Croip3/MK4-Prototype/GehaeuseAiPrototype/vorschau/03_draufsicht.png

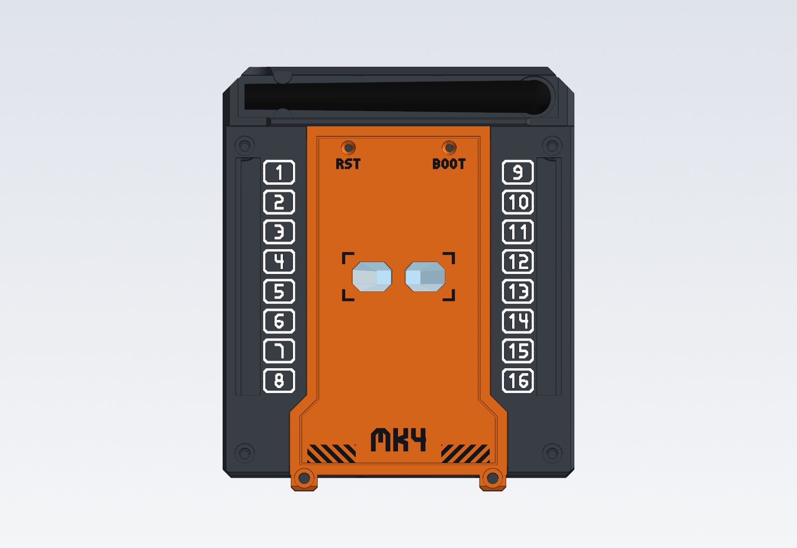
GehaeuseAiPrototype/vorschau/03_draufsicht.png
