Croip3/MK4-Prototype/GehaeuseAiPrototype/vorschau/05_unterseite.png

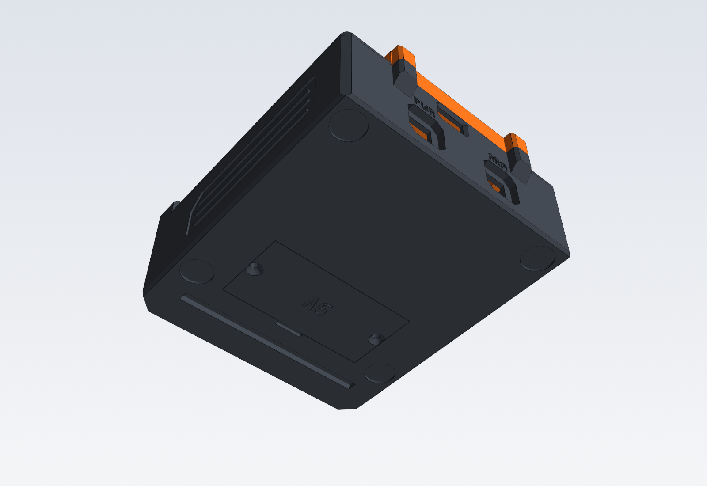
GehaeuseAiPrototype/vorschau/05_unterseite.png
