Croip3/MK4-Prototype/GehaeuseAiPrototype/vorschau/07_leuchtend.png

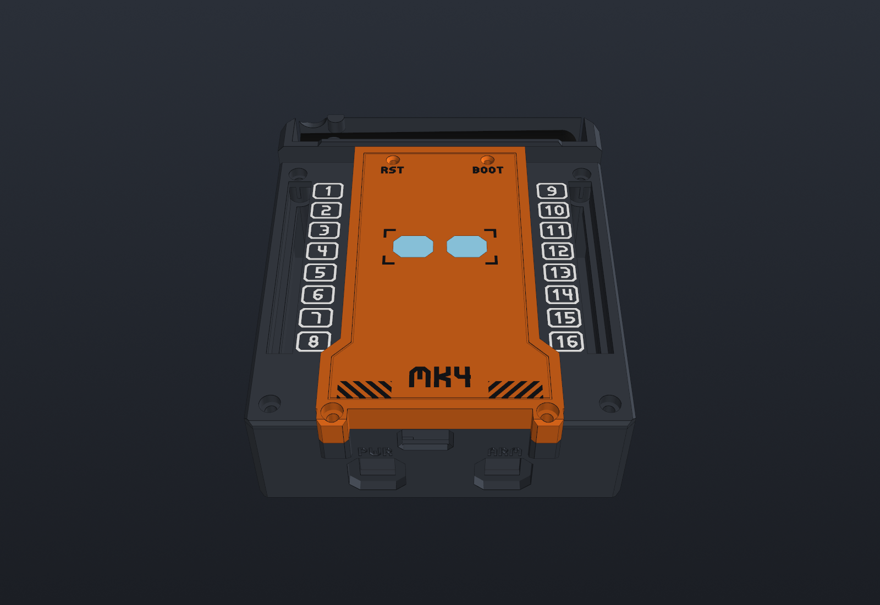
GehaeuseAiPrototype/vorschau/07_leuchtend.png
