Croip3/MK4-Prototype/GehaeuseAiPrototype/vorschau/10_schnitt_antenne.png

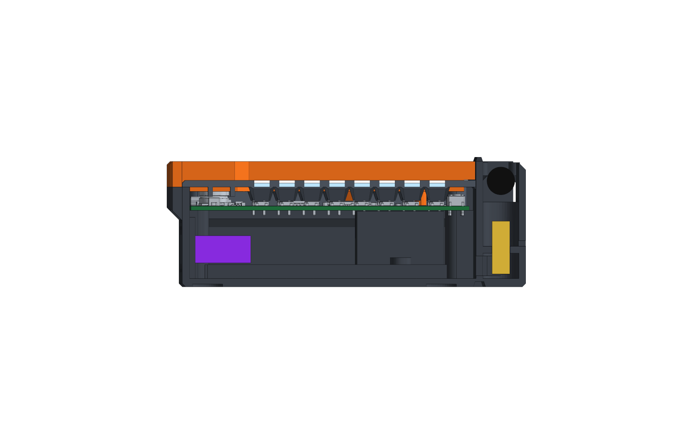
GehaeuseAiPrototype/vorschau/10_schnitt_antenne.png
