Croip3/MK4-Prototype/GehaeuseAiPrototype/vorschau/11_schnitt_status_led.png

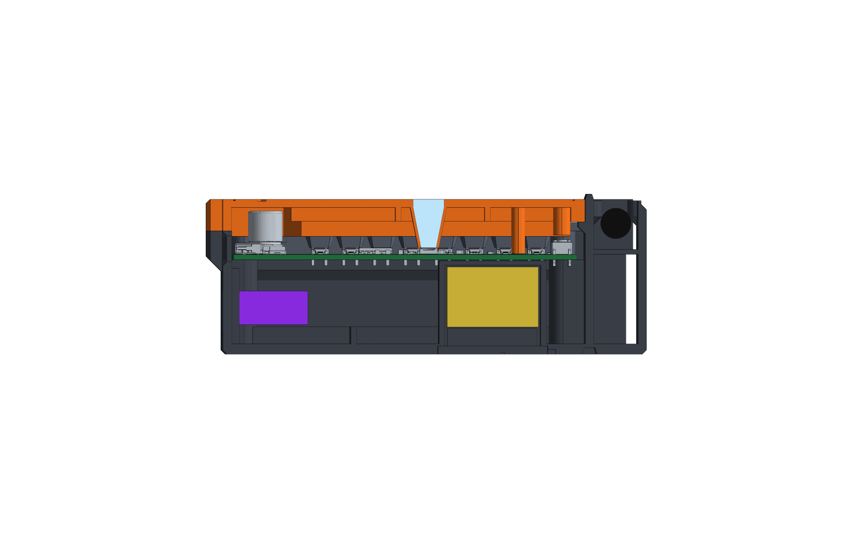
GehaeuseAiPrototype/vorschau/11_schnitt_status_led.png
