Croip3/MK4-Prototype/GehaeuseAiPrototype/vorschau/12_schnitt_elkos.png

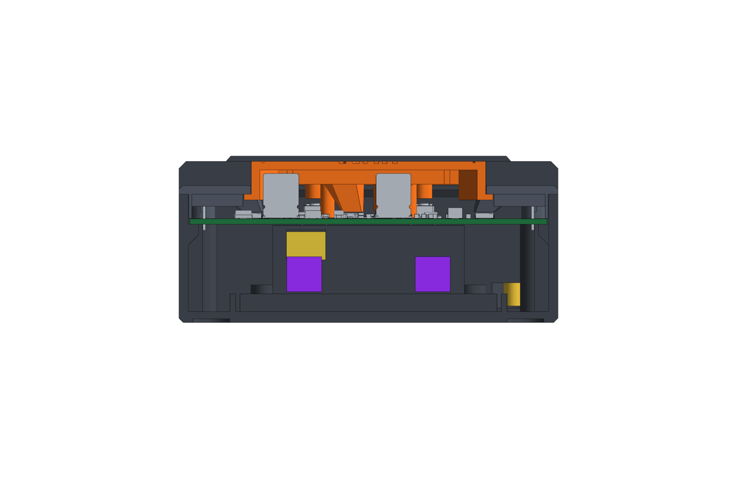
GehaeuseAiPrototype/vorschau/12_schnitt_elkos.png
