Croip3/MK4-Prototype/GehaeuseAiPrototype/STEP/MK4_Gehaeuse_Baugruppe.step

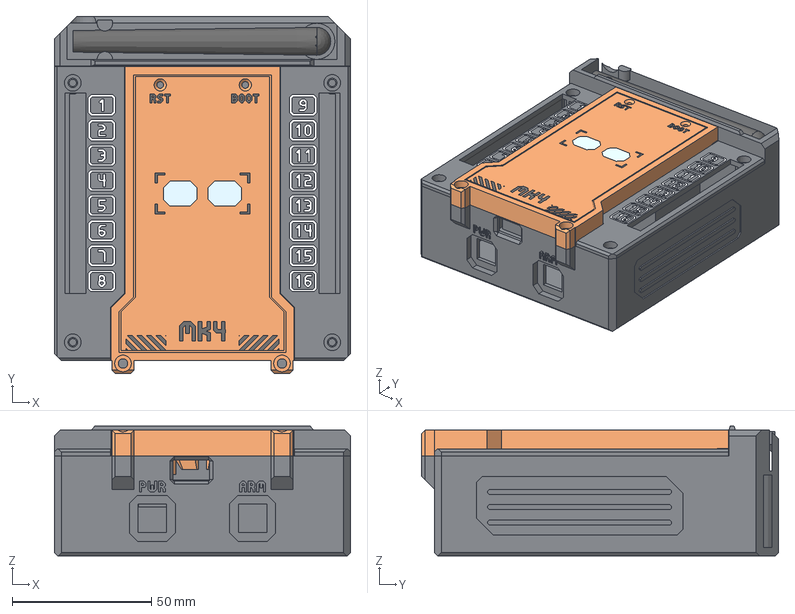
[picture p13: CAD file, 2026-11-11]
GehaeuseAiPrototype/STEP/MK4_Gehaeuse_Baugruppe.step
106.2 x 128.0 x 46.6 mm
Unterteil
Haube_Koerper
Haube_Lichtleiter_transparent
Haube_Beschriftung_Kontrastfarbe
PaneelL_Koerper
PaneelL_Lichtleiter_transparent
PaneelL_Ziffern_transparent
PaneelR_Koerper
PaneelR_Lichtleiter_transparent
PaneelR_Ziffern_transparent
Batteriedeckel
Antenne_eingeklappt_Referenz
