Croip3/MK4-Prototype/GehaeuseAiPrototype/3MF/MK4_alle_Teile.3mf

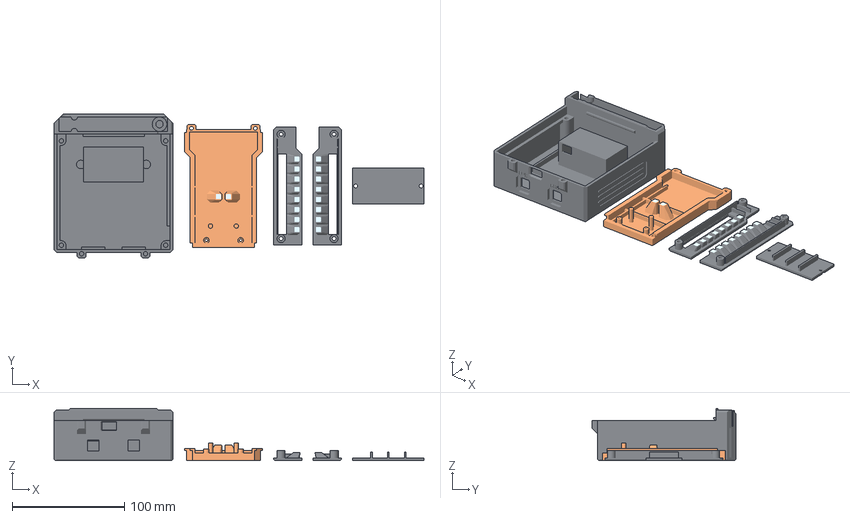
[picture p14: CAD file, 2026-11-11]
GehaeuseAiPrototype/3MF/MK4_alle_Teile.3mf
329.9 x 128.0 x 46.6 mm
MK4_01_Unterteil
MK4_02_Haube
MK4_03_Seitenpaneel_L_Kanal_1-8
MK4_04_Seitenpaneel_R_Kanal_9-16
MK4_05_Batteriedeckel
