Croip3/MK4-Prototype/GehaeuseAiPrototype/quelle/pcb.step

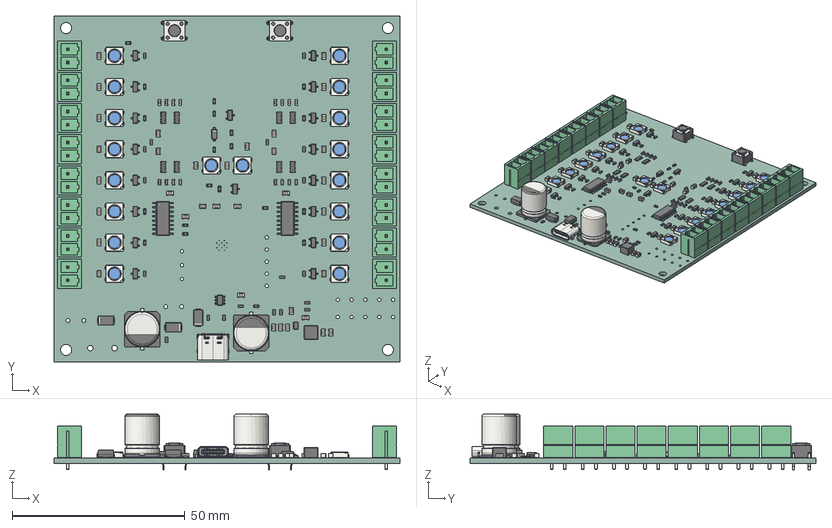
[picture p15: CAD file, 2026-11-11]
GehaeuseAiPrototype/quelle/pcb.step
100.0 x 100.0 x 16.1 mm
pin1 x 16
pin2 x 16
C_0805_2012Metric x 37
C_0603_1608Metric x 16
USB_C_Receptacle_16P_TopMnt_Horizontal_GCT_USB4105-xx-A
R_0603_1608Metric x 39
SOT-23 x 18
SOT-23-6
LED_WS2812B_PLCC4_50x50mm_P32mm x 18
R_Array_Convex_4x0603 x 8
D_SMA x 3
CP_Elec_10x126 x 2
SOIC-16_3.9x9.9mm_P1.27mm x 2
D_SOD-123
SOT-583-8
SW_PUSH_6mm x 2
a68460a4-8551-11ed-a139-00155d22e2d7_part
a684622a-8551-11ed-a139-00155d22e2d7_part
a68462b6-8551-11ed-a139-00155d22e2d7_part
MK4-Proto_PCB
