Croip3/MK4-Prototype/GehaeuseAiPrototype/STL/MK4_01_Unterteil__Unterteil.stl

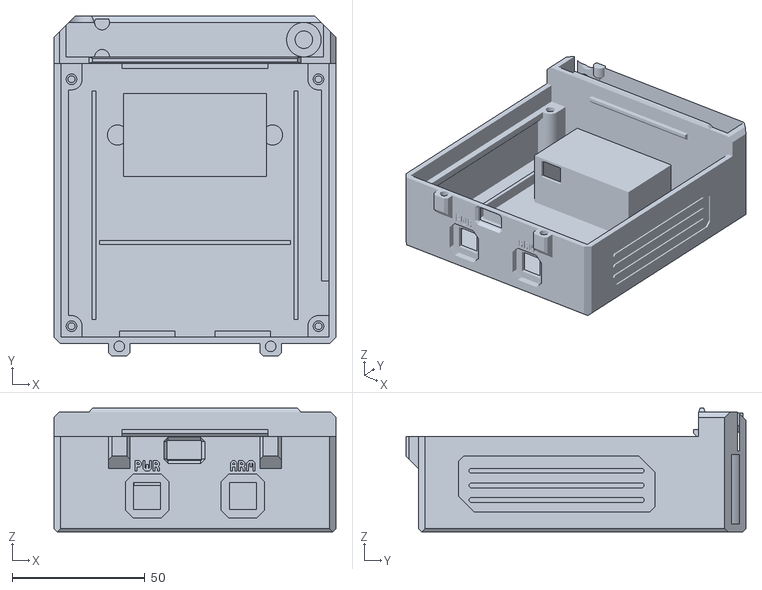
[picture p16: CAD file, 2026-11-11]
GehaeuseAiPrototype/STL/MK4_01_Unterteil__Unterteil.stl
106.2 x 128.0 x 46.6
