Croip3/MK4-Prototype/GehaeuseAiPrototype/STEP/MK4_03_Seitenpaneel_L_Kanal_1-8.step

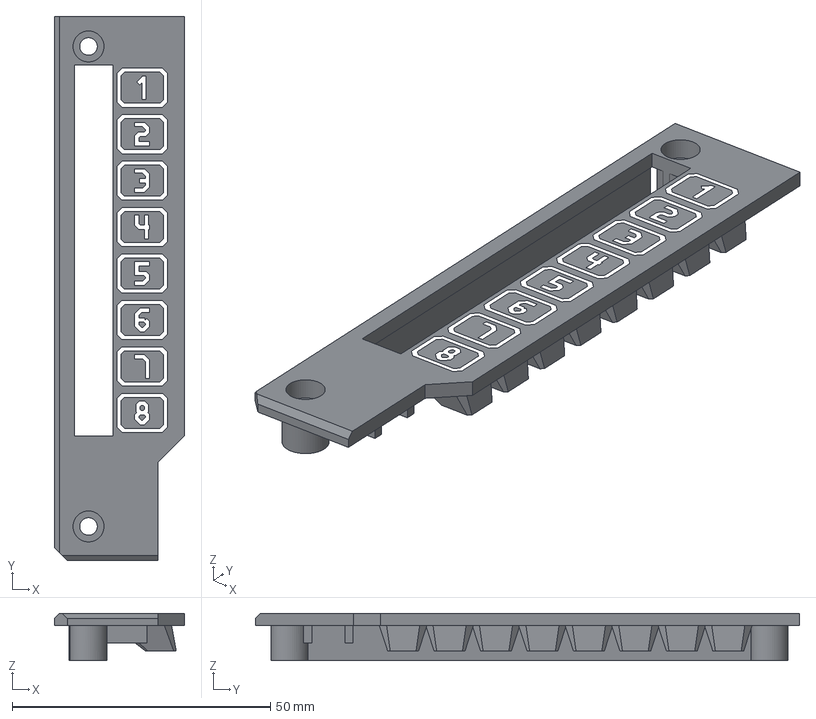
[picture p17: CAD file, 2026-11-11]
GehaeuseAiPrototype/STEP/MK4_03_Seitenpaneel_L_Kanal_1-8.step
25.2 x 105.4 x 9.20 mm
PaneelL_Koerper
PaneelL_Lichtleiter_transparent
PaneelL_Ziffern_transparent
