Croip3/MK4-Prototype/GehaeuseAiPrototype/STL/MK4_02_Haube__Haube_Lichtleiter_transparent.stl

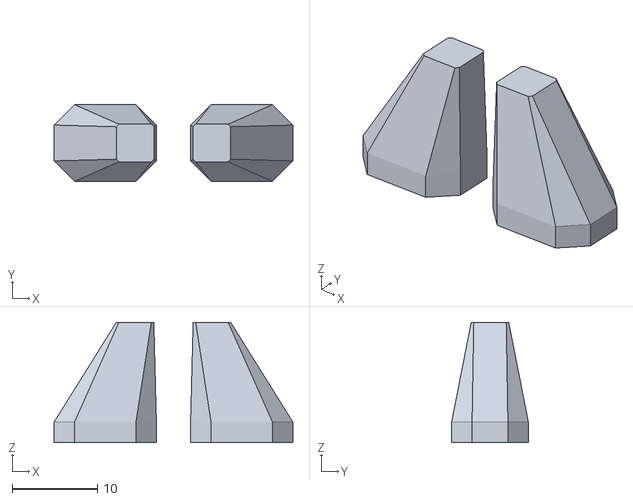
[picture p18: CAD file, 2026-11-11]
GehaeuseAiPrototype/STL/MK4_02_Haube__Haube_Lichtleiter_transparent.stl
28.0 x 9.00 x 14.1
