Croip3/MK4-Prototype/GehaeuseAiPrototype/STL/MK4_04_Seitenpaneel_R_Kanal_9-16__PaneelR_Lichtleiter_transparent.stl

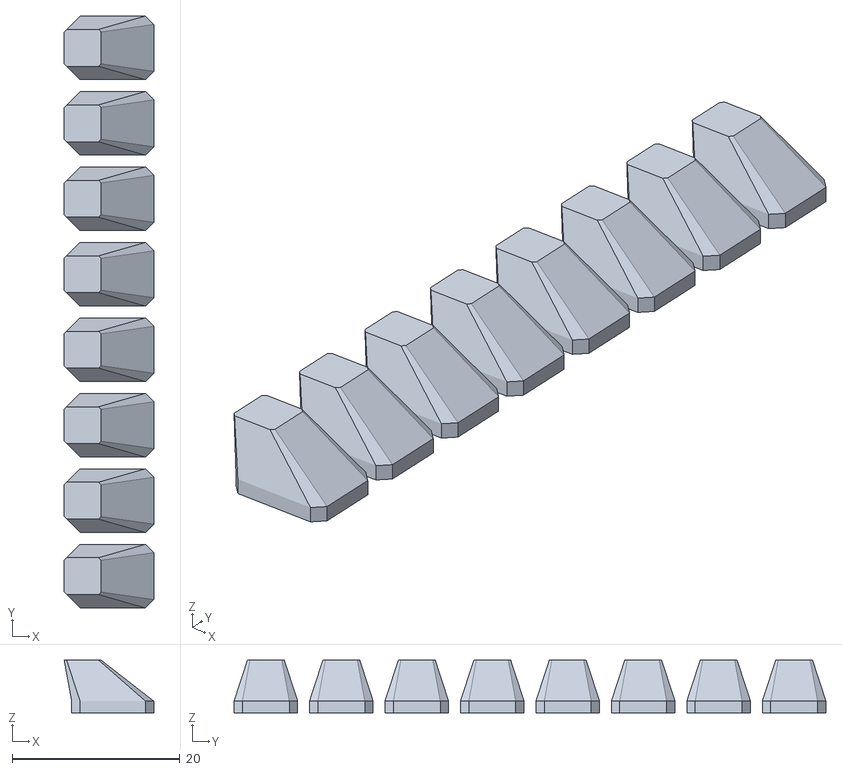
[picture p19: CAD file, 2026-11-11]
GehaeuseAiPrototype/STL/MK4_04_Seitenpaneel_R_Kanal_9-16__PaneelR_Lichtleiter_transparent.stl
10.7 x 70.6 x 6.30
