Croip3/MK4-Prototype/GehaeuseAiPrototype/STEP/MK4_05_Batteriedeckel.step

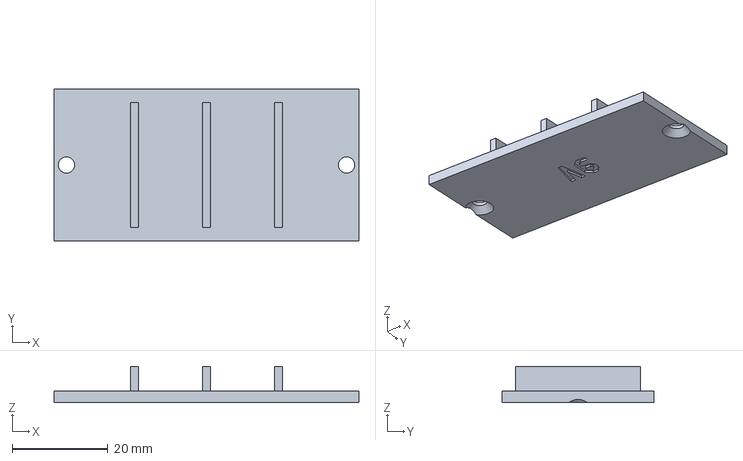
[picture p20: CAD file, 2026-11-11]
GehaeuseAiPrototype/STEP/MK4_05_Batteriedeckel.step
63.6 x 31.8 x 7.60 mm
