Croip3/MK4-Prototype/GehaeuseAiPrototype/STL/MK4_03_Seitenpaneel_L_Kanal_1-8__PaneelL_Ziffern_transparent.stl

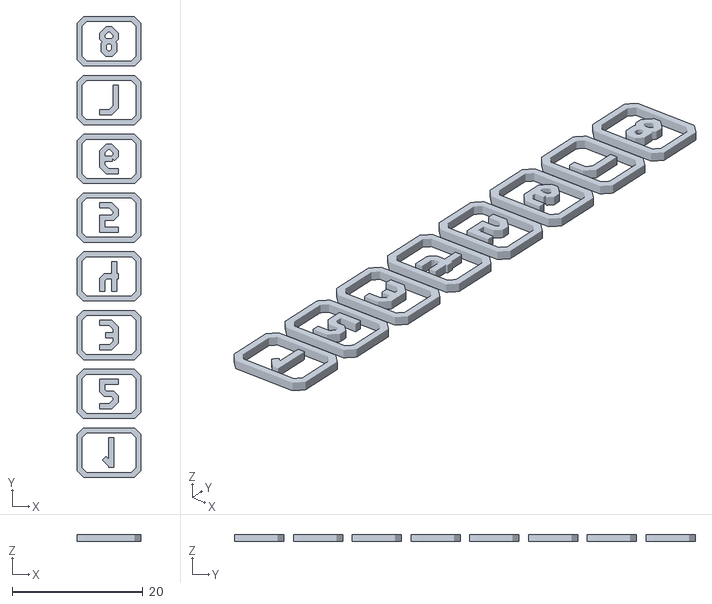
[picture p21: CAD file, 2026-11-11]
GehaeuseAiPrototype/STL/MK4_03_Seitenpaneel_L_Kanal_1-8__PaneelL_Ziffern_transparent.stl
9.80 x 70.6 x 1.00
