Croip3/MK4-Prototype/GehaeuseAiPrototype/STL/MK4_03_Seitenpaneel_L_Kanal_1-8__PaneelL_Koerper.stl

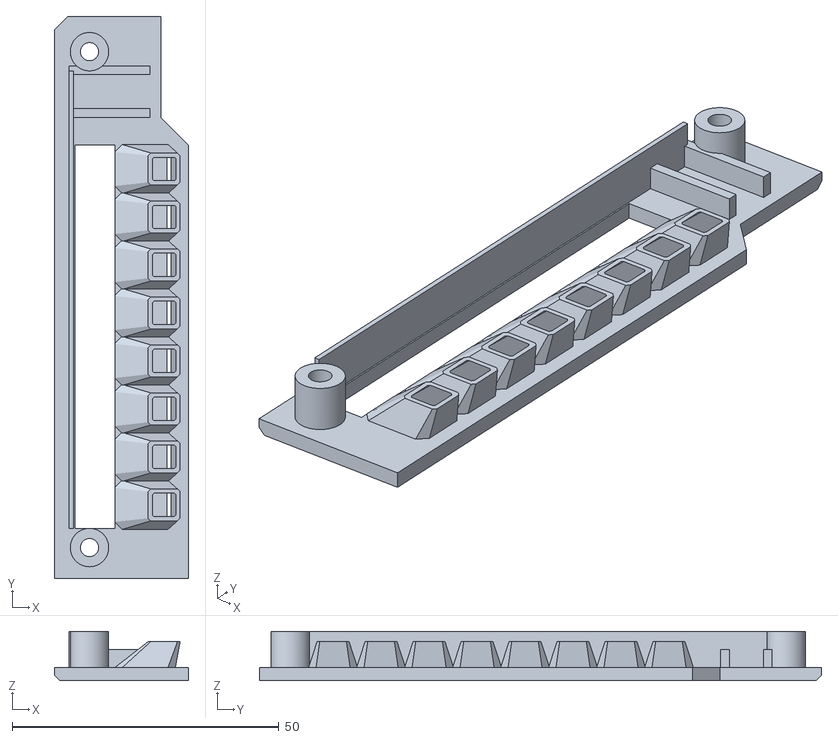
[picture p22: CAD file, 2026-11-11]
GehaeuseAiPrototype/STL/MK4_03_Seitenpaneel_L_Kanal_1-8__PaneelL_Koerper.stl
25.2 x 105.4 x 9.20
