Croip3/MK4-Prototype/GehaeuseAiPrototype/STEP/MK4_02_Haube.step

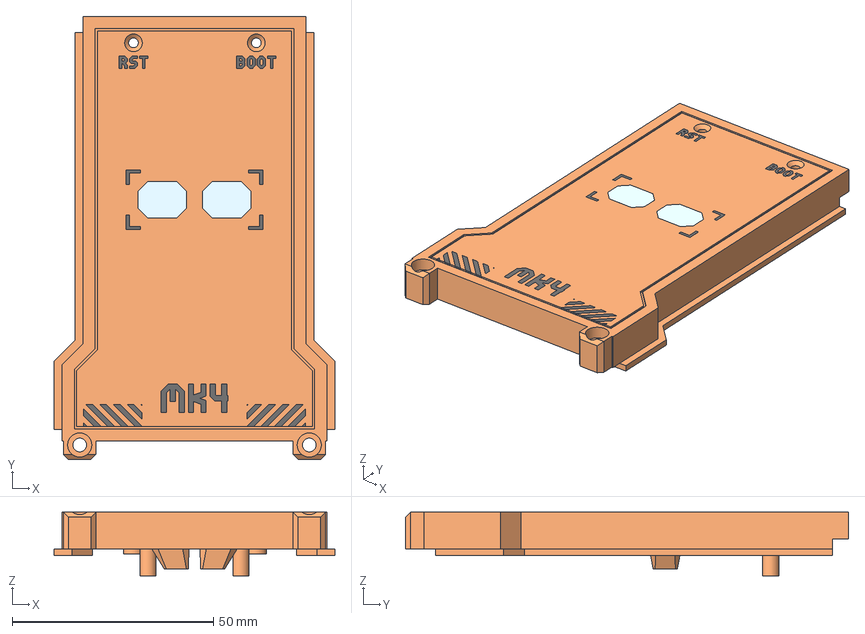
[picture p23: CAD file, 2026-11-11]
GehaeuseAiPrototype/STEP/MK4_02_Haube.step
69.7 x 110.0 x 15.8 mm
Haube_Koerper
Haube_Lichtleiter_transparent
Haube_Beschriftung_Kontrastfarbe
