Croip3/MK4-Prototype/GehaeuseAiPrototype/STL/MK4_02_Haube__Haube_Beschriftung_Kontrastfarbe.stl

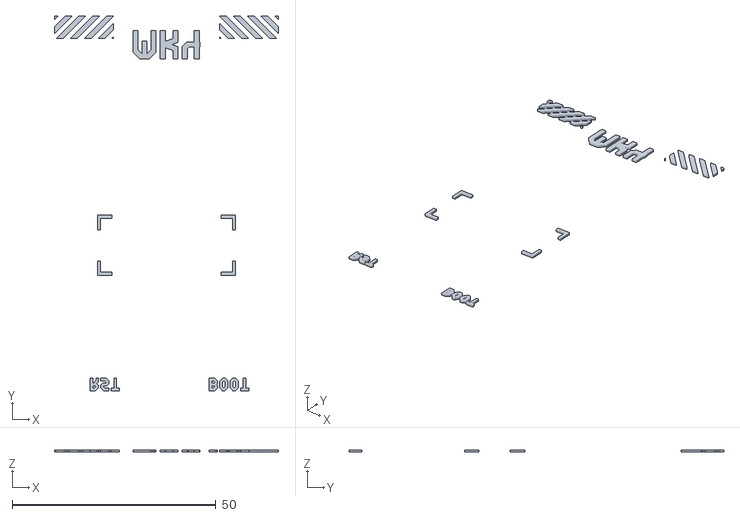
[picture p24: CAD file, 2026-11-11]
GehaeuseAiPrototype/STL/MK4_02_Haube__Haube_Beschriftung_Kontrastfarbe.stl
55.0 x 92.0 x 0.6
