Croip3/MK4-Prototype/GehaeuseAiPrototype/STL/MK4_02_Haube__Haube_Koerper.stl

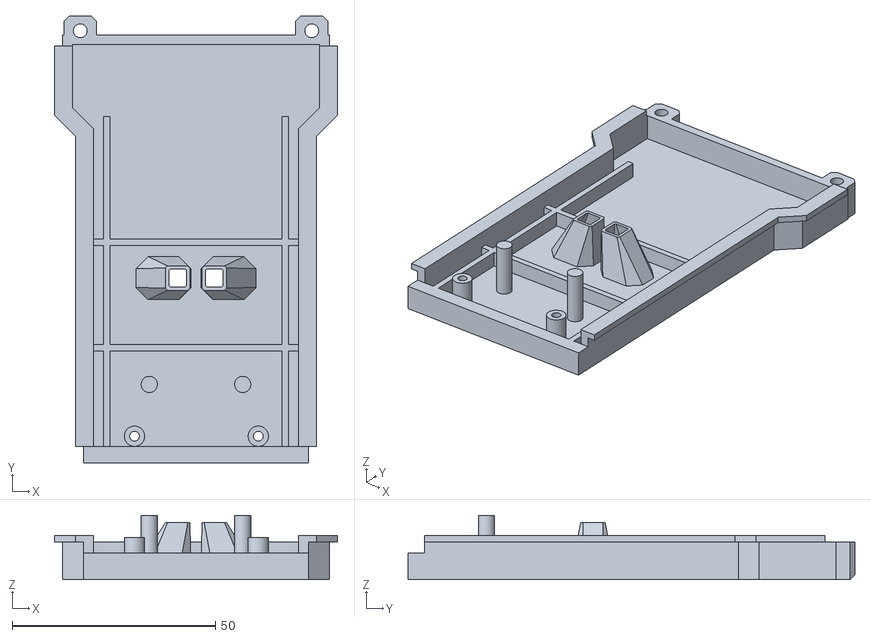
[picture p25: CAD file, 2026-11-11]
GehaeuseAiPrototype/STL/MK4_02_Haube__Haube_Koerper.stl
69.7 x 110.0 x 15.8
