Croip3/MK4-Prototype/GehaeuseAiPrototype/STL/MK4_04_Seitenpaneel_R_Kanal_9-16__PaneelR_Ziffern_transparent.stl

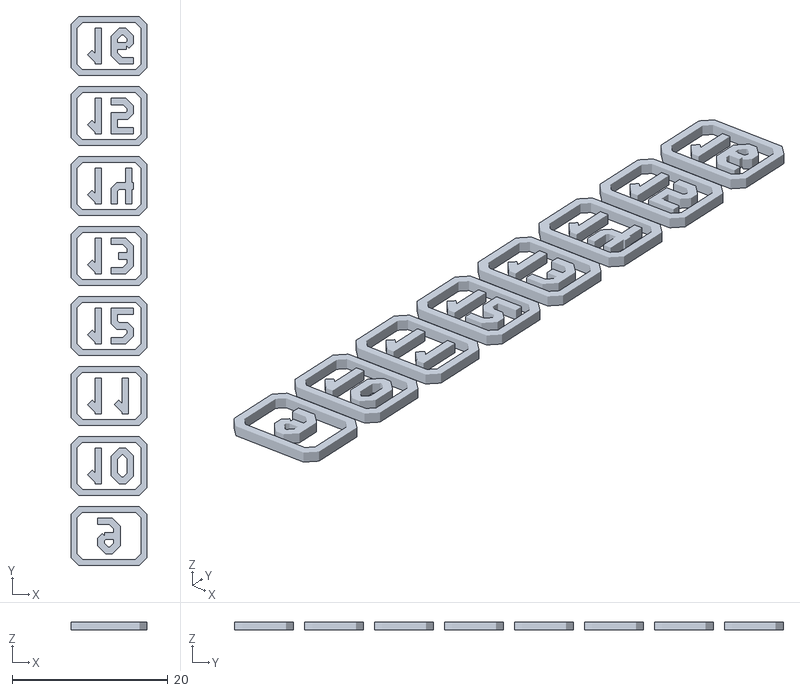
[picture p26: CAD file, 2026-11-11]
GehaeuseAiPrototype/STL/MK4_04_Seitenpaneel_R_Kanal_9-16__PaneelR_Ziffern_transparent.stl
9.80 x 70.6 x 1.00
