Croip3/MK4-Prototype/(list of files, cad)

Other CAD files:
GehaeuseAiPrototype/STEP/MK4_Gehaeuse_Baugruppe_mit_Platine.step
GehaeuseAiPrototype/STEP/MK4_01_Unterteil.step
GehaeuseAiPrototype/STEP/MK4_04_Seitenpaneel_R_Kanal_9-16.step
GehaeuseAiPrototype/STL/MK4_05_Batteriedeckel__Batteriedeckel.stl
GehaeuseAiPrototype/STL/MK4_03_Seitenpaneel_L_Kanal_1-8__PaneelL_Lichtleiter_transparent.stl
GehaeuseAiPrototype/STL/MK4_04_Seitenpaneel_R_Kanal_9-16__PaneelR_Koerper.stl
GehaeuseAiPrototype/3MF/MK4_01_Unterteil.3mf
GehaeuseAiPrototype/3MF/MK4_02_Haube.3mf
GehaeuseAiPrototype/3MF/MK4_03_Seitenpaneel_L_Kanal_1-8.3mf
GehaeuseAiPrototype/3MF/MK4_04_Seitenpaneel_R_Kanal_9-16.3mf
GehaeuseAiPrototype/3MF/MK4_05_Batteriedeckel.3mf
