Croip3/MK4-Prototype/MK4-Proto/MK4-Proto.kicad_pcb

## KiCad design MK4-Proto/MK4-Proto.kicad_pcb (2026-11-11)

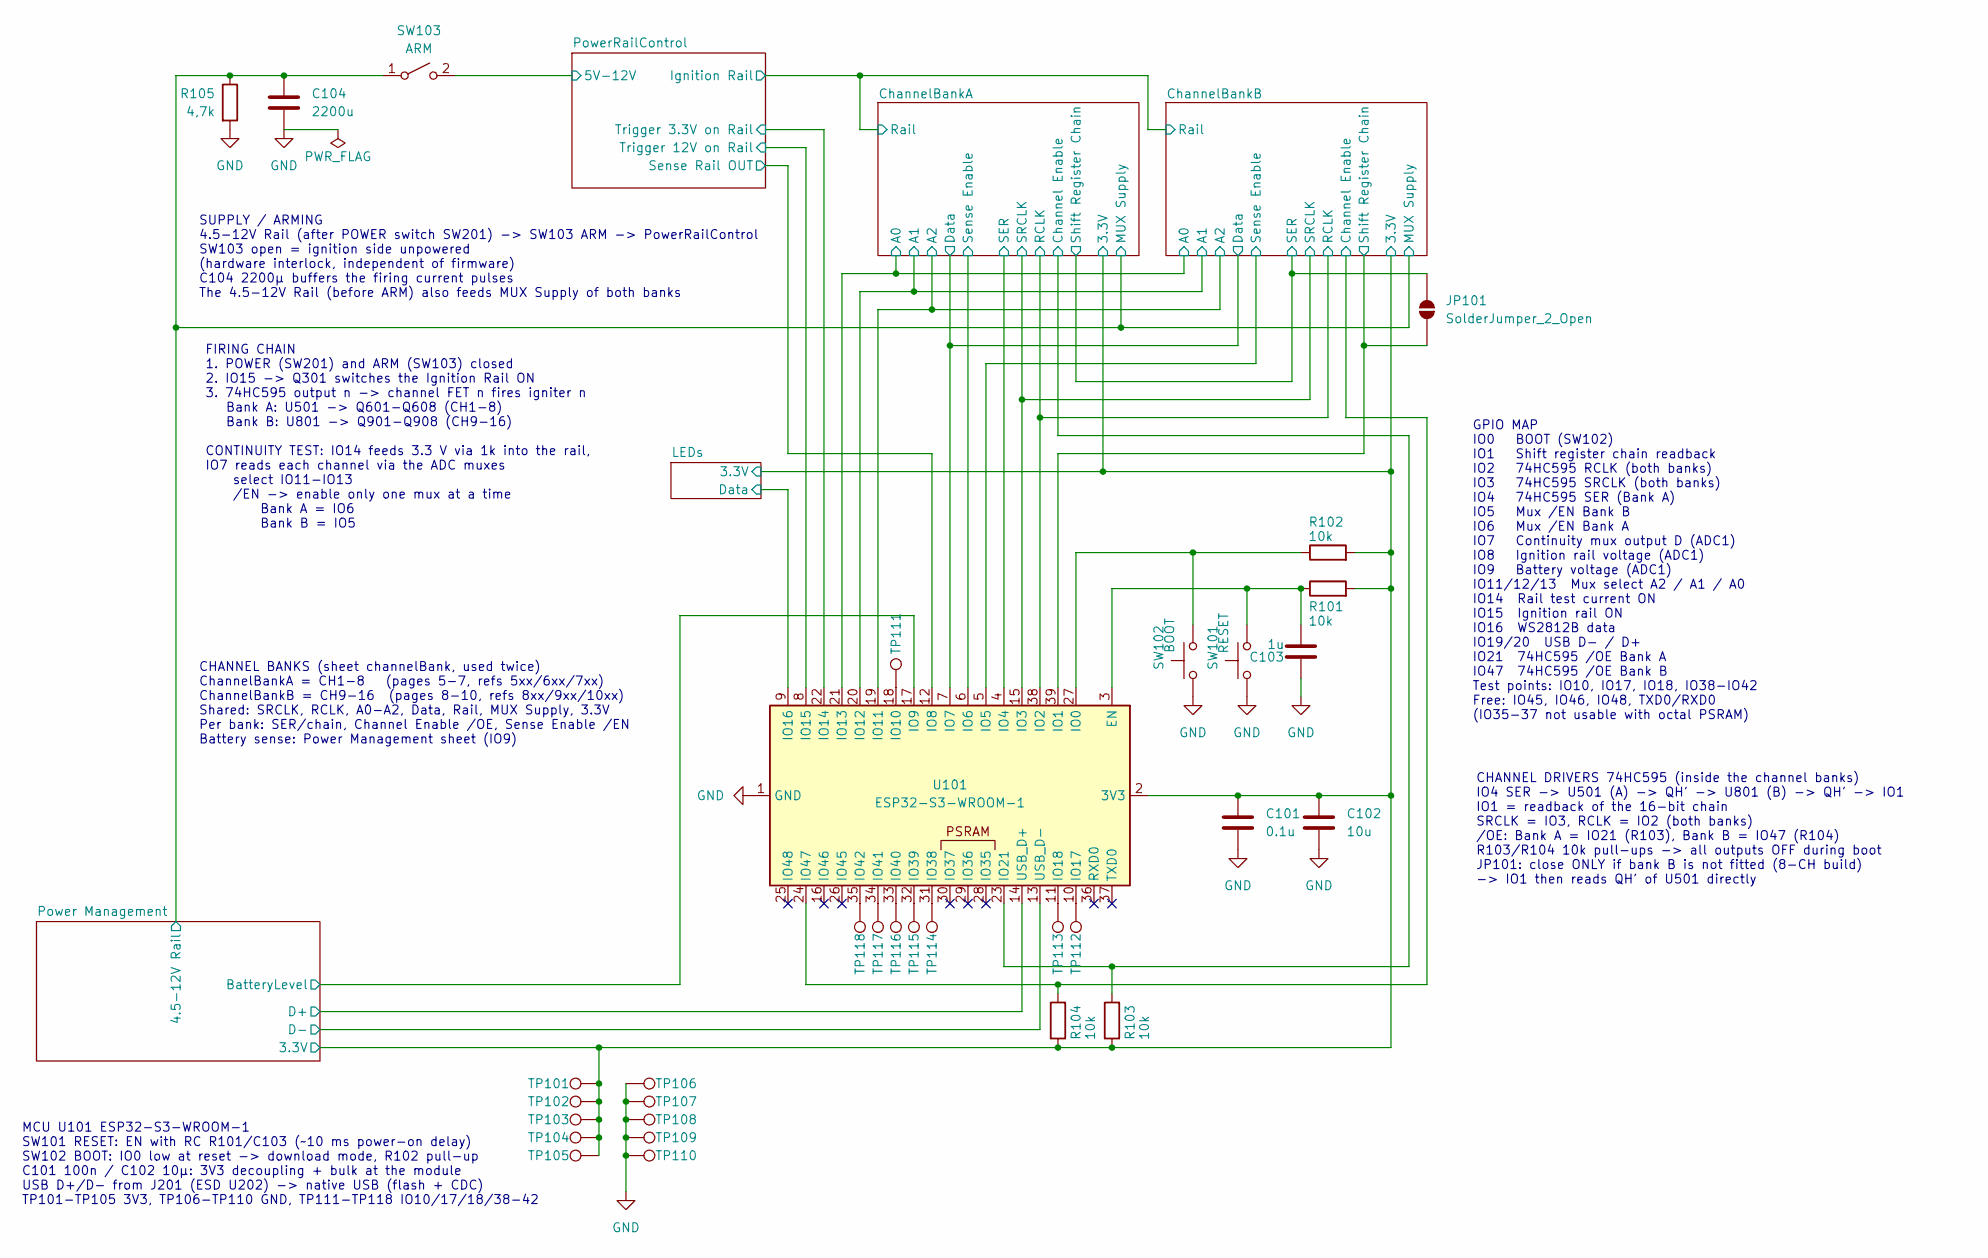
[picture p37: schematic MK4-Proto.kicad_sch, MK4-Proto (Zündanlage MK4 Prototype)]

Parts:
C101: 0.1u; C_0805_2012Metric_Pad1.18x1.45mm_HandSolder; LCSC C49678
C102: 10u; C_0805_2012Metric_Pad1.18x1.45mm_HandSolder; LCSC C15850
C103: 1u; C_0805_2012Metric_Pad1.18x1.45mm_HandSolder; LCSC C28323
C104: 2200u; CP_Elec_10x12.6; LCSC C48542923
JP101: SolderJumper_2_Open; SolderJumper-2_P1.3mm_Open_RoundedPad1.0x1.5mm
R101, R102, R103, R104: 10k; R_0603_1608Metric_Pad0.98x0.95mm_HandSolder; LCSC C25804
R105: 4,7k; R_0603_1608Metric_Pad0.98x0.95mm_HandSolder; LCSC C23162
SW101: RESET; SW_PUSH_6mm; LCSC C393938
SW102: BOOT; SW_PUSH_6mm; LCSC C393938
SW103: ARM; SolderWire-0.5sqmm_1x02_P4.6mm_D0.9mm_OD2.1mm
TP101, TP102, TP103, TP104, TP105: 3V3; TestPoint_THTPad_D2.0mm_Drill1.0mm
TP106, TP107, TP108, TP109, TP110: GND; TestPoint_THTPad_D2.0mm_Drill1.0mm
TP111: IO10; TestPoint_THTPad_D2.0mm_Drill1.0mm
TP112: IO17; TestPoint_THTPad_D2.0mm_Drill1.0mm
TP113: IO18; TestPoint_THTPad_D2.0mm_Drill1.0mm
TP114: IO38; TestPoint_THTPad_D2.0mm_Drill1.0mm
TP115: IO39; TestPoint_THTPad_D2.0mm_Drill1.0mm
TP116: IO40; TestPoint_THTPad_D2.0mm_Drill1.0mm
TP117: IO41; TestPoint_THTPad_D2.0mm_Drill1.0mm
TP118: IO42; TestPoint_THTPad_D2.0mm_Drill1.0mm
U101: ESP32-S3-WROOM-1; ESP32-S3-WROOM-1U; LCSC C3013944

Connections:
/ChannelBankA/3.3V: C101.1, C102.1, R101.2, R102.2, R103.1, R104.1, TP101.1 (1_1), TP102.1 (1_1), TP103.1 (1_1), TP104.1 (1_1), TP105.1 (1_1), U101.2 (3V3); also elsewhere on the board
/ChannelBankA/A0: U101.21 (IO13); also elsewhere on the board
/ChannelBankA/A1: U101.20 (IO12); also elsewhere on the board
/ChannelBankA/A2: U101.19 (IO11); also elsewhere on the board
/ChannelBankA/Channel Enable: R103.2, U101.23 (IO21); also elsewhere on the board
/ChannelBankA/Data: U101.7 (IO7); also elsewhere on the board
/ChannelBankA/MUX Supply: C104.1, R105.1, SW103.1 (A); also elsewhere on the board
/ChannelBankA/RCLK: U101.38 (IO2); also elsewhere on the board
/ChannelBankA/SER: U101.4 (IO4); also elsewhere on the board
/ChannelBankA/SRCLK: U101.15 (IO3); also elsewhere on the board
/ChannelBankA/Sense Enable: U101.6 (IO6); also elsewhere on the board
/ChannelBankA/Shift Register Chain: JP101.2 (B); also elsewhere on the board
/ChannelBankB/Channel Enable: R104.2, U101.24 (IO47); also elsewhere on the board
/ChannelBankB/Sense Enable: U101.5 (IO5); also elsewhere on the board
/ChannelBankB/Shift Register Chain: JP101.1 (A), U101.39 (IO1); also elsewhere on the board
/LEDs/Data: U101.9 (IO16); also elsewhere on the board
/Power Management/BatteryLevel: U101.17 (IO9); also elsewhere on the board
/Power Management/D+: U101.14 (USB_D+); also elsewhere on the board
/Power Management/D-: U101.13 (USB_D-); also elsewhere on the board
/PowerRailControl/5V-12V: SW103.2 (B); also elsewhere on the board
/PowerRailControl/Sense Rail OUT: U101.12 (IO8); also elsewhere on the board
/PowerRailControl/Trigger 3.3V on Rail: U101.22 (IO14); also elsewhere on the board
/PowerRailControl/Trigger 12V on Rail: U101.8 (IO15); also elsewhere on the board
GND: C101.2, C102.2, C103.1, C104.2, R105.2, SW101.1, SW102.1, TP106.1 (1_1), TP107.1 (1_1), TP108.1 (1_1), TP109.1 (1_1), TP110.1 (1_1), U101.1 (GND), U101.40 (GND), U101.41 (GND); also elsewhere on the board
unnamed: C103.2, R101.1, SW101.2, U101.3 (EN)
unnamed: R102.1, SW102.2, U101.27 (IO0)
unnamed: TP111.1 (1_1), U101.18 (IO10)
unnamed: TP112.1 (1_1), U101.10 (IO17)
unnamed: TP113.1 (1_1), U101.11 (IO18)
unnamed: TP114.1 (1_1), U101.31 (IO38)
unnamed: TP115.1 (1_1), U101.32 (IO39)
unnamed: TP116.1 (1_1), U101.33 (IO40)
unnamed: TP117.1 (1_1), U101.34 (IO41)
unnamed: TP118.1 (1_1), U101.35 (IO42)

Notes on the sheet:
SUPPLY / ARMING 4.5-12V Rail (after POWER switch SW201) -> SW103 ARM -> PowerRailControl SW103 open = ignition side unpowered (hardware interlock, independent of firmware) C104 2200µ buffers the firing current pulses The 4.5-12V Rail (before ARM) also feeds MUX Supply of both banks
CHANNEL DRIVERS 74HC595 (inside the channel banks) IO4 SER -> U501 (A) -> QH' -> U801 (B) -> QH' -> IO1 IO1 = readback of the 16-bit chain SRCLK = IO3, RCLK = IO2 (both banks) /OE: Bank A = IO21 (R103), Bank B = IO47 (R104) R103/R104 10k pull-ups -> all outputs OFF during boot JP101: close ONLY if 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
FIRING CHAIN 1. POWER (SW201) and ARM (SW103) closed 2. IO15 -> Q301 switches the Ignition Rail ON 3. 74HC595 output n -> channel FET n fires igniter n Bank A: U501 -> Q601-Q608 (CH1-8) Bank B: U801 -> Q901-Q908 (CH9-16) CONTINUITY TEST: IO14 feeds 3.3 V via 1k into the rail, IO7 reads each channel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
MCU U101 ESP32-S3-WROOM-1 SW101 RESET: EN with RC R101/C103 (~10 ms power-on delay) SW102 BOOT: IO0 low at reset -> download mode, R102 pull-up C101 100n / C102 10µ: 3V3 decoupling + bulk at the module USB D+/D- from J201 (ESD U202) -> native USB (flash + CDC) TP101-TP105 3V3, TP106-TP110 GND, TP11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
GPIO MAP IO0 BOOT (SW102) IO1 Shift register chain readback IO2 74HC595 RCLK (both banks) IO3 74HC595 SRCLK (both banks) IO4 74HC595 SER (Bank A) IO5 Mux /EN Bank B IO6 Mux /EN Bank A IO7 Continuity mux output D (ADC1) IO8 Ignition rail voltage (ADC1) IO9 Battery voltage (ADC1) IO11/12/13 Mux selec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
CHANNEL BANKS (sheet channelBank, used twice) ChannelBankA = CH1-8 (pages 5-7, refs 5xx/6xx/7xx) ChannelBankB = CH9-16 (pages 8-10, refs 8xx/9xx/10xx) Shared: SRCLK, RCLK, A0-A2, Data, Rail, MUX Supply, 3.3V Per bank: SER/chain, Channel Enable /OE, Sense Enable /EN Battery sense: Power Management s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

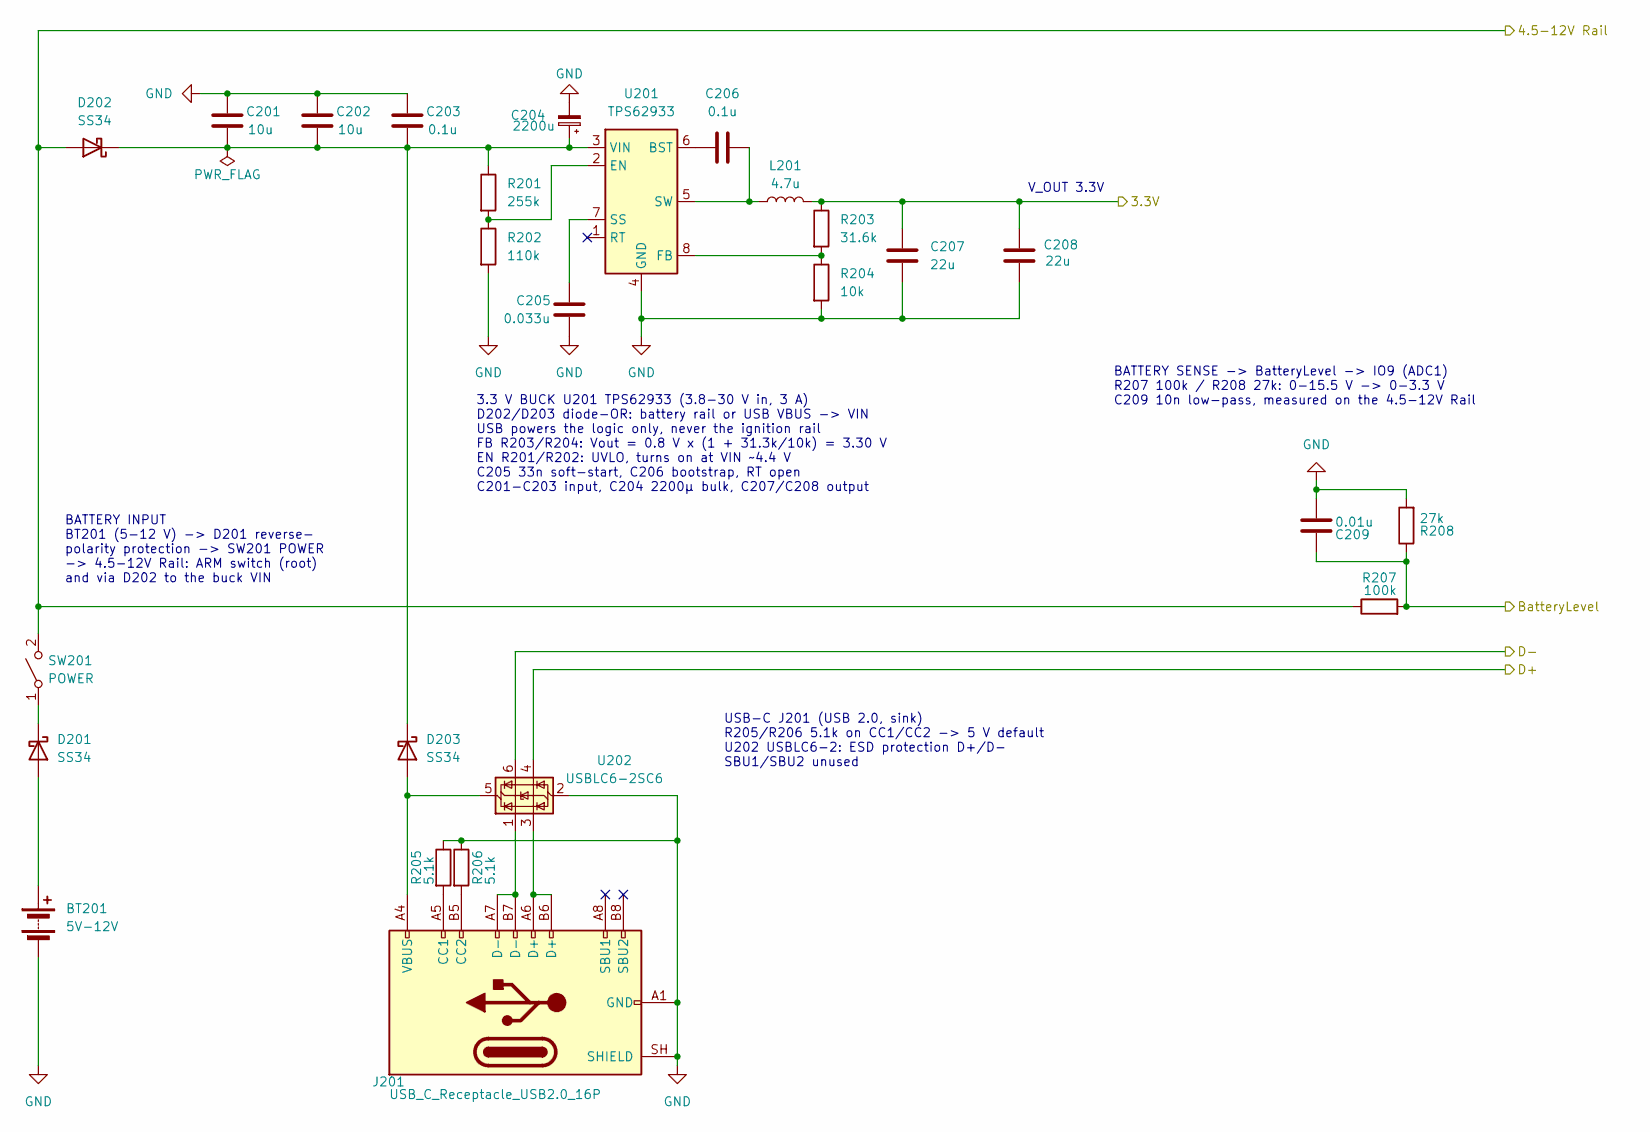
[picture p38: schematic PowerManagement.kicad_sch, Power Management]

Parts:
BT201: 5V-12V; SolderWire-0.75sqmm_1x02_P7mm_D1.25mm_OD3.5mm
C201, C202: 10u; C_0805_2012Metric_Pad1.18x1.45mm_HandSolder; LCSC C15850
C203, C206: 0.1u; C_0805_2012Metric_Pad1.18x1.45mm_HandSolder; LCSC C49678
C204: 2200u; CP_Elec_10x12.6; LCSC C48542923
C205: 0.033u; C_0805_2012Metric_Pad1.18x1.45mm_HandSolder; LCSC C1739
C207, C208: 22u; C_0805_2012Metric_Pad1.18x1.45mm_HandSolder; LCSC C45783
C209: 0.01u; C_0805_2012Metric_Pad1.18x1.45mm_HandSolder; LCSC C1710
D201, D202, D203: SS34; D_SMA; LCSC C8678
J201: USB_C_Receptacle_USB2.0_16P; USB_C_Receptacle_GCT_USB4105-xx-A_16P_TopMnt_Horizontal; LCSC C5184243
L201: 4.7u; L_Sunlord_SWPA4030S; LCSC C57269
R201: 255k; R_0603_1608Metric_Pad0.98x0.95mm_HandSolder; LCSC C23354
R202: 110k; R_0603_1608Metric_Pad0.98x0.95mm_HandSolder; LCSC C25805
R203: 31.6k; R_0603_1608Metric_Pad0.98x0.95mm_HandSolder; LCSC C25967
R204: 10k; R_0603_1608Metric_Pad0.98x0.95mm_HandSolder; LCSC C25804
R205, R206: 5.1k; R_0603_1608Metric_Pad0.98x0.95mm_HandSolder; LCSC C23186
R207: 100k; R_0603_1608Metric_Pad0.98x0.95mm_HandSolder; LCSC C25803
R208: 27k; R_0603_1608Metric_Pad0.98x0.95mm_HandSolder; LCSC C22967
SW201: POWER; SolderWire-0.5sqmm_1x02_P4.6mm_D0.9mm_OD2.1mm
U201: TPS62933; SOT-583-8; LCSC C3200405
U202: USBLC6-2SC6; SOT-23-6; LCSC C7519

Connections:
/ChannelBankA/3.3V: C207.1, C208.1, L201.2, R203.1; also elsewhere on the board
/ChannelBankA/MUX Supply: D202.2 (A), R207.1, SW201.2 (B); also elsewhere on the board
/Power Management/BatteryLevel: C209.2, R207.2, R208.1; also elsewhere on the board
/Power Management/D+: U202.4 (I/O2); also elsewhere on the board
/Power Management/D-: U202.6 (I/O1); also elsewhere on the board
GND: BT201.2 (-), C201.1, C202.1, C203.1, C204.2, C205.2, C207.2, C208.2, C209.1, J201.A1 (GND), J201.A12 (GND), J201.B1 (GND), J201.B12 (GND), J201.SH (SHIELD), R202.2, R204.2, R205.1, R206.1, R208.2, U201.4 (GND), U202.2 (GND); also elsewhere on the board
unnamed: BT201.1 (+), D201.2 (A)
unnamed: D201.1 (K), SW201.1 (A)
unnamed: C201.2, C202.2, C203.2, C204.1, D202.1 (K), D203.1 (K), R201.1, U201.3 (VIN)
unnamed: D203.2 (A), J201.A4 (VBUS), J201.A9 (VBUS), J201.B4 (VBUS), J201.B9 (VBUS), U202.5 (VBUS)
unnamed: J201.A5 (CC1), R205.2
unnamed: J201.B5 (CC2), R206.2
unnamed: J201.A6 (D+), J201.B6 (D+), U202.3 (I/O2)
unnamed: J201.A7 (D-), J201.B7 (D-), U202.1 (I/O1)
unnamed: C206.1, U201.6 (BST)
unnamed: R201.2, R202.1, U201.2 (EN)
unnamed: R203.2, R204.1, U201.8 (FB)
unnamed: C205.1, U201.7 (SS)
unnamed: C206.2, L201.1, U201.5 (SW)

Notes on the sheet:
3.3 V BUCK U201 TPS62933 (3.8-30 V in, 3 A) D202/D203 diode-OR: battery rail or USB VBUS -> VIN USB powers the logic only, never the ignition rail FB R203/R204: Vout = 0.8 V x (1 + 31.3k/10k) = 3.30 V EN R201/R202: UVLO, turns on at VIN ~4.4 V C205 33n soft-start, C206 bootstrap, RT open C201-C203 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
USB-C J201 (USB 2.0, sink) R205/R206 5.1k on CC1/CC2 -> 5 V default U202 USBLC6-2: ESD protection D+/D- SBU1/SBU2 unused
V_OUT 3.3V
BATTERY INPUT BT201 (5-12 V) -> D201 reverse- polarity protection -> SW201 POWER -> 4.5-12V Rail: ARM switch (root) and via D202 to the buck VIN
BATTERY SENSE -> BatteryLevel -> IO9 (ADC1) R207 100k / R208 27k: 0-15.5 V -> 0-3.3 V C209 10n low-pass, measured on the 4.5-12V Rail

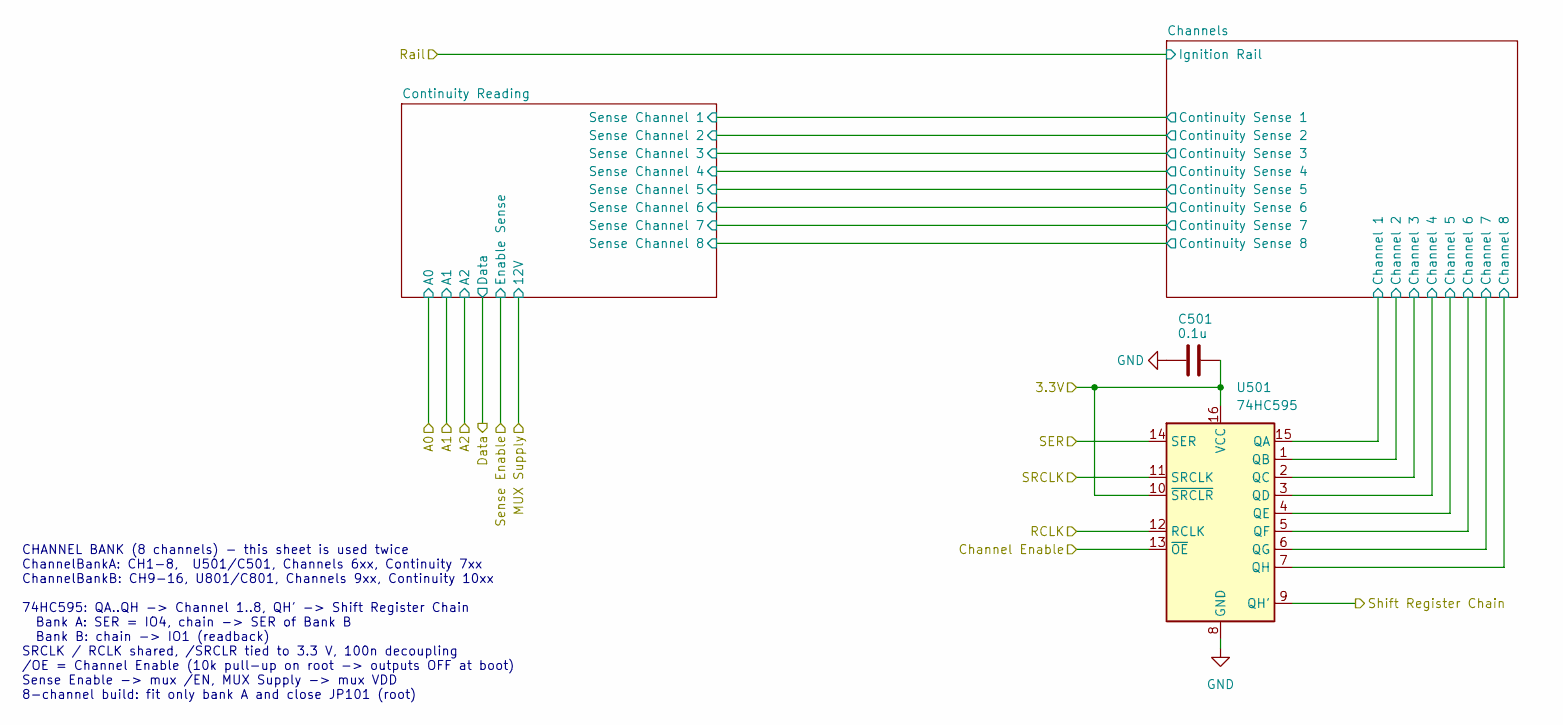
[picture p39: schematic channelBank.kicad_sch, Channel Bank]

Parts:
C501: 0.1u; C_0805_2012Metric_Pad1.18x1.45mm_HandSolder; LCSC C49678
U501: 74HC595; SOIC-16_3.9x9.9mm_P1.27mm; LCSC C5947

Connections:
/ChannelBankA/3.3V: C501.2, U501.10 (~SRCLR), U501.16 (VCC); also elsewhere on the board
/ChannelBankA/Channel Enable: U501.13 (~OE); also elsewhere on the board
/ChannelBankA/Channels/Channel 1: U501.15 (QA); also elsewhere on the board
/ChannelBankA/Channels/Channel 2: U501.1 (QB); also elsewhere on the board
/ChannelBankA/Channels/Channel 3: U501.2 (QC); also elsewhere on the board
/ChannelBankA/Channels/Channel 4: U501.3 (QD); also elsewhere on the board
/ChannelBankA/Channels/Channel 5: U501.4 (QE); also elsewhere on the board
/ChannelBankA/Channels/Channel 6: U501.5 (QF); also elsewhere on the board
/ChannelBankA/Channels/Channel 7: U501.6 (QG); also elsewhere on the board
/ChannelBankA/Channels/Channel 8: U501.7 (QH); also elsewhere on the board
/ChannelBankA/RCLK: U501.12 (RCLK); also elsewhere on the board
/ChannelBankA/SER: U501.14 (SER); also elsewhere on the board
/ChannelBankA/SRCLK: U501.11 (SRCLK); also elsewhere on the board
/ChannelBankA/Shift Register Chain: U501.9 (QH'); also elsewhere on the board
GND: C501.1, U501.8 (GND); also elsewhere on the board

Parts of its further copies:
C801: 0.1u; C_0805_2012Metric_Pad1.18x1.45mm_HandSolder; LCSC C49678
U801: 74HC595; SOIC-16_3.9x9.9mm_P1.27mm; LCSC C5947

Connections of its further copies:
/ChannelBankA/3.3V: C801.2, U801.10 (~SRCLR), U801.16 (VCC); also elsewhere on the board
/ChannelBankA/RCLK: U801.12 (RCLK); also elsewhere on the board
/ChannelBankA/SRCLK: U801.11 (SRCLK); also elsewhere on the board
/ChannelBankA/Shift Register Chain: U801.14 (SER); also elsewhere on the board
/ChannelBankB/Channel Enable: U801.13 (~OE); also elsewhere on the board
/ChannelBankB/Channels/Channel 1: U801.15 (QA); also elsewhere on the board
/ChannelBankB/Channels/Channel 2: U801.1 (QB); also elsewhere on the board
/ChannelBankB/Channels/Channel 3: U801.2 (QC); also elsewhere on the board
/ChannelBankB/Channels/Channel 4: U801.3 (QD); also elsewhere on the board
/ChannelBankB/Channels/Channel 5: U801.4 (QE); also elsewhere on the board
/ChannelBankB/Channels/Channel 6: U801.5 (QF); also elsewhere on the board
/ChannelBankB/Channels/Channel 7: U801.6 (QG); also elsewhere on the board
/ChannelBankB/Channels/Channel 8: U801.7 (QH); also elsewhere on the board
/ChannelBankB/Shift Register Chain: U801.9 (QH'); also elsewhere on the board
GND: C801.1, U801.8 (GND); also elsewhere on the board

Notes on the sheet:
CHANNEL BANK (8 channels) - this sheet is used twice ChannelBankA: CH1-8, U501/C501, Channels 6xx, Continuity 7xx ChannelBankB: CH9-16, U801/C801, Channels 9xx, Continuity 10xx 74HC595: QA..QH -> Channel 1..8, QH' -> Shift Register Chain Bank A: SER = IO4, chain -> SER of Bank B Bank B: chain -> IO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

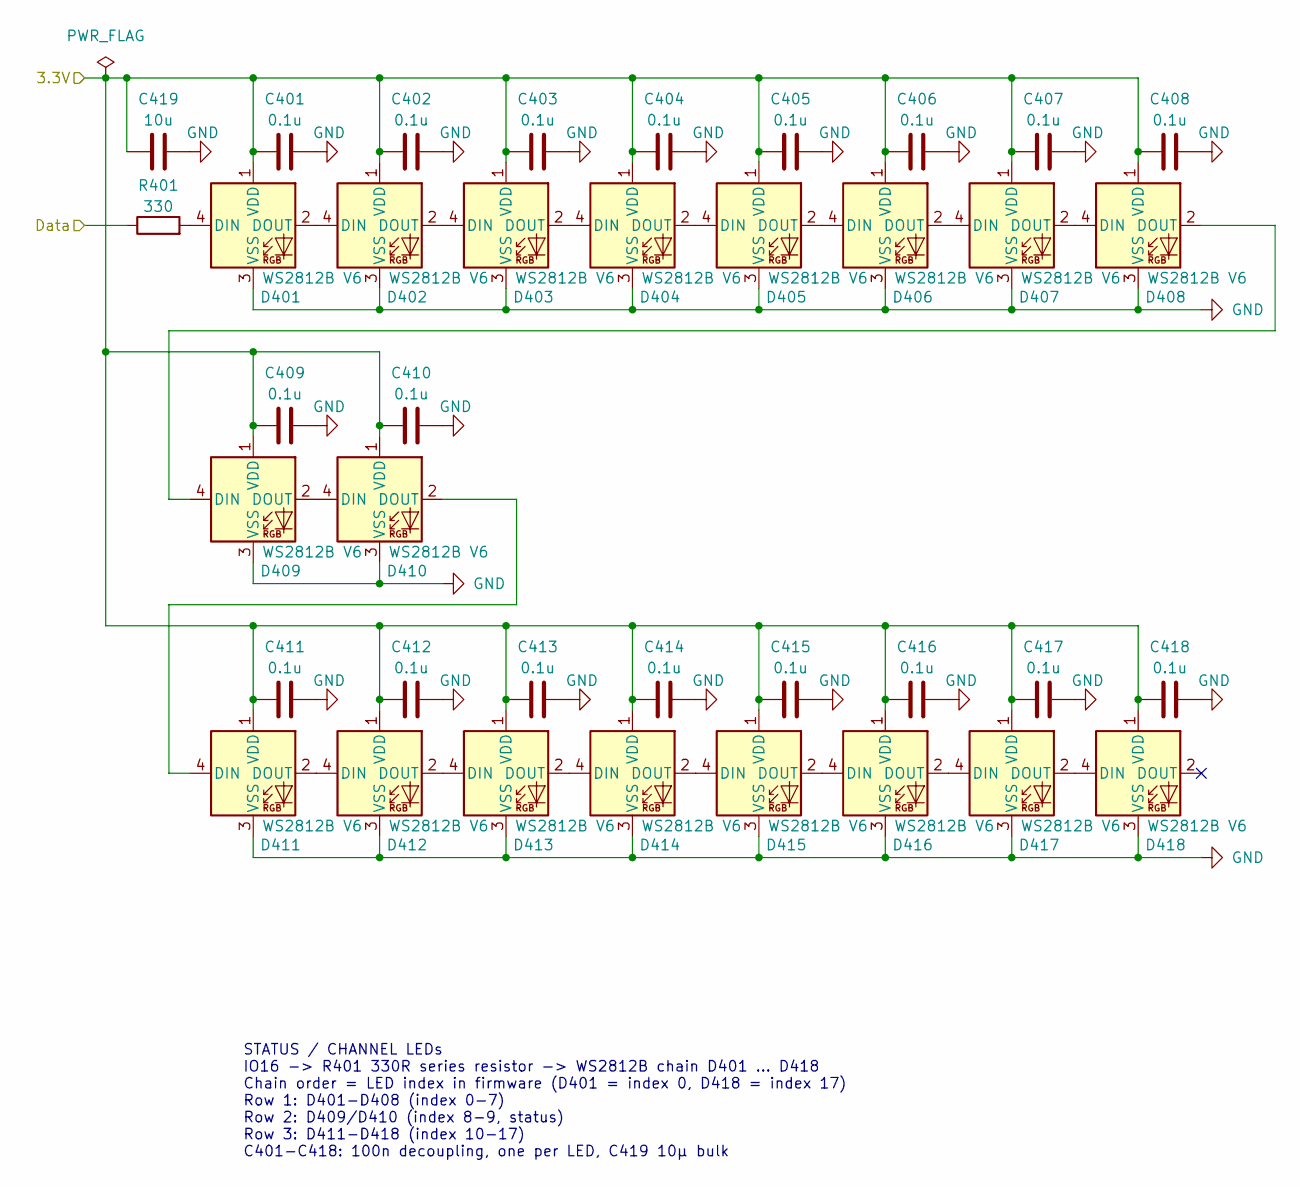
[picture p40: schematic leds.kicad_sch]

Parts:
C401, C402, C403, C404, C405, C406, C407, C408, C409, C410, C411, C412, C413, C414, C415, C416, C417, C418: 0.1u; C_0805_2012Metric_Pad1.18x1.45mm_HandSolder; LCSC C49678
C419: 10u; C_0805_2012Metric_Pad1.18x1.45mm_HandSolder; LCSC C15850
D401, D402, D403, D404, D405, D406, D407, D408, D409, D410, D411, D412, D413, D414, D415, D416, D417, D418: WS2812B V6; LED_WS2812B_PLCC4_5.0x5.0mm_P3.2mm; LCSC C52917433
R401: 330; R_0603_1608Metric_Pad0.98x0.95mm_HandSolder; LCSC C23138

Connections:
/ChannelBankA/3.3V: C401.1, C402.1, C403.1, C404.1, C405.1, C406.1, C407.1, C408.1, C409.1, C410.1, C411.1, C412.1, C413.1, C414.1, C415.1, C416.1, C417.1, C418.1, C419.1, D401.1 (VDD), D402.1 (VDD), D403.1 (VDD), D404.1 (VDD), D405.1 (VDD), D406.1 (VDD), D407.1 (VDD), D408.1 (VDD), D409.1 (VDD), D410.1 (VDD), D411.1 (VDD), D412.1 (VDD), D413.1 (VDD), D414.1 (VDD), D415.1 (VDD), D416.1 (VDD), D417.1 (VDD), D418.1 (VDD); also elsewhere on the board
/LEDs/Data: R401.1; also elsewhere on the board
GND: C401.2, C402.2, C403.2, C404.2, C405.2, C406.2, C407.2, C408.2, C409.2, C410.2, C411.2, C412.2, C413.2, C414.2, C415.2, C416.2, C417.2, C418.2, C419.2, D401.3 (VSS), D402.3 (VSS), D403.3 (VSS), D404.3 (VSS), D405.3 (VSS), D406.3 (VSS), D407.3 (VSS), D408.3 (VSS), D409.3 (VSS), D410.3 (VSS), D411.3 (VSS), D412.3 (VSS), D413.3 (VSS), D414.3 (VSS), D415.3 (VSS), D416.3 (VSS), D417.3 (VSS), D418.3 (VSS); also elsewhere on the board
unnamed: D401.4 (DIN), R401.2
unnamed: D401.2 (DOUT), D402.4 (DIN)
unnamed: D402.2 (DOUT), D403.4 (DIN)
unnamed: D403.2 (DOUT), D404.4 (DIN)
unnamed: D404.2 (DOUT), D405.4 (DIN)
unnamed: D405.2 (DOUT), D406.4 (DIN)
unnamed: D406.2 (DOUT), D407.4 (DIN)
unnamed: D407.2 (DOUT), D408.4 (DIN)
unnamed: D408.2 (DOUT), D409.4 (DIN)
unnamed: D409.2 (DOUT), D410.4 (DIN)
unnamed: D410.2 (DOUT), D411.4 (DIN)
unnamed: D411.2 (DOUT), D412.4 (DIN)
unnamed: D412.2 (DOUT), D413.4 (DIN)
unnamed: D413.2 (DOUT), D414.4 (DIN)
unnamed: D414.2 (DOUT), D415.4 (DIN)
unnamed: D415.2 (DOUT), D416.4 (DIN)
unnamed: D416.2 (DOUT), D417.4 (DIN)
unnamed: D417.2 (DOUT), D418.4 (DIN)

Notes on the sheet:
STATUS / CHANNEL LEDs IO16 -> R401 330R series resistor -> WS2812B chain D401 ... D418 Chain order = LED index in firmware (D401 = index 0, D418 = index 17) Row 1: D401-D408 (index 0-7) Row 2: D409/D410 (index 8-9, status) Row 3: D411-D418 (index 10-17) C401-C418: 100n decoupling, one per LED, C419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

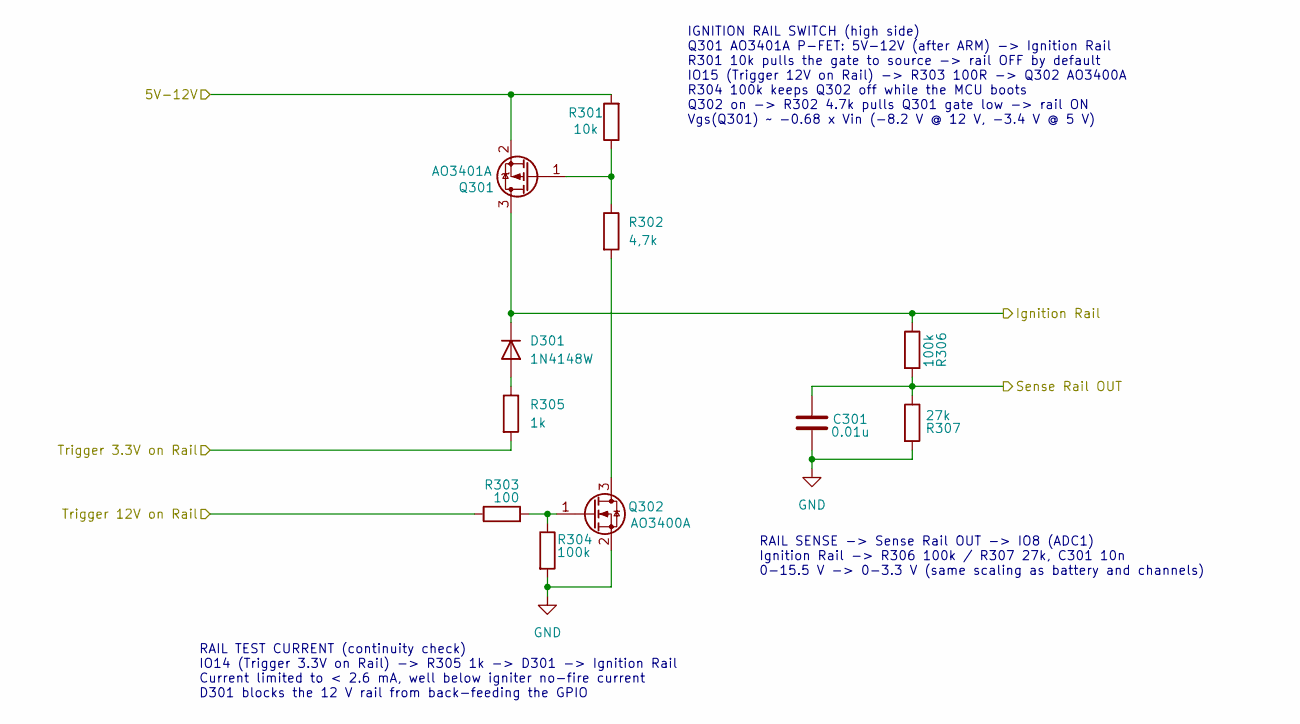
[picture p41: schematic testing.kicad_sch, Ignition & Test Rail Control]

Parts:
C301: 0.01u; C_0805_2012Metric_Pad1.18x1.45mm_HandSolder; LCSC C1710
D301: 1N4148W; D_SOD-123; LCSC C81598
Q301: AO3401A; SOT-23; LCSC C15127
Q302: AO3400A; SOT-23; LCSC C20917
R301: 10k; R_0603_1608Metric_Pad0.98x0.95mm_HandSolder; LCSC C25804
R302: 4,7k; R_0603_1608Metric_Pad0.98x0.95mm_HandSolder; LCSC C23162
R303: 100; R_0603_1608Metric_Pad0.98x0.95mm_HandSolder; LCSC C22775
R304, R306: 100k; R_0603_1608Metric_Pad0.98x0.95mm_HandSolder; LCSC C25803
R305: 1k; R_0603_1608Metric_Pad0.98x0.95mm_HandSolder; LCSC C21190
R307: 27k; R_0603_1608Metric_Pad0.98x0.95mm_HandSolder; LCSC C22967

Connections:
/ChannelBankA/Rail: D301.1 (K), Q301.3 (D), R306.1; also elsewhere on the board
/PowerRailControl/5V-12V: Q301.2 (S), R301.2; also elsewhere on the board
/PowerRailControl/Sense Rail OUT: C301.2, R306.2, R307.1; also elsewhere on the board
/PowerRailControl/Trigger 3.3V on Rail: R305.2; also elsewhere on the board
/PowerRailControl/Trigger 12V on Rail: R303.1; also elsewhere on the board
GND: C301.1, Q302.2 (S), R304.2, R307.2; also elsewhere on the board
unnamed: D301.2 (A), R305.1
unnamed: Q301.1 (G), R301.1, R302.1
unnamed: Q302.3 (D), R302.2
unnamed: Q302.1 (G), R303.2, R304.1

Notes on the sheet:
IGNITION RAIL SWITCH (high side) Q301 AO3401A P-FET: 5V-12V (after ARM) -> Ignition Rail R301 10k pulls the gate to source -> rail OFF by default IO15 (Trigger 12V on Rail) -> R303 100R -> Q302 AO3400A R304 100k keeps Q302 off while the MCU boots Q302 on -> R302 4.7k pulls Q301 gate low -> rail ON 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
RAIL SENSE -> Sense Rail OUT -> IO8 (ADC1) Ignition Rail -> R306 100k / R307 27k, C301 10n 0-15.5 V -> 0-3.3 V (same scaling as battery and channels)
RAIL TEST CURRENT (continuity check) IO14 (Trigger 3.3V on Rail) -> R305 1k -> D301 -> Ignition Rail Current limited to < 2.6 mA, well below igniter no-fire current D301 blocks the 12 V rail from back-feeding the GPIO

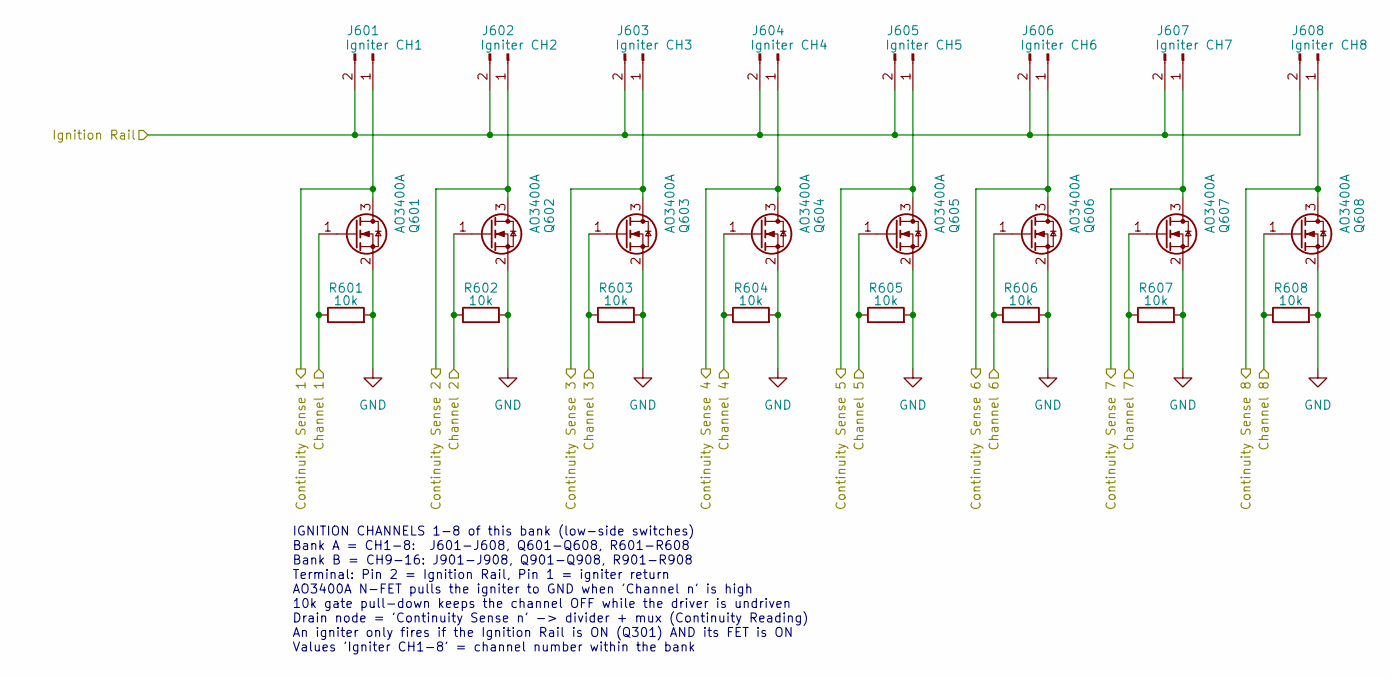
[picture p42: schematic channels.kicad_sch]

Parts:
J601: Igniter CH1; CamdenBoss_CTB932VE-2_1x02_P3.81mm_Vertical
J602: Igniter CH2; CamdenBoss_CTB932VE-2_1x02_P3.81mm_Vertical
J603: Igniter CH3; CamdenBoss_CTB932VE-2_1x02_P3.81mm_Vertical
J604: Igniter CH4; CamdenBoss_CTB932VE-2_1x02_P3.81mm_Vertical
J605: Igniter CH5; CamdenBoss_CTB932VE-2_1x02_P3.81mm_Vertical
J606: Igniter CH6; CamdenBoss_CTB932VE-2_1x02_P3.81mm_Vertical
J607: Igniter CH7; CamdenBoss_CTB932VE-2_1x02_P3.81mm_Vertical
J608: Igniter CH8; CamdenBoss_CTB932VE-2_1x02_P3.81mm_Vertical
Q601, Q602, Q603, Q604, Q605, Q606, Q607, Q608: AO3400A; SOT-23; LCSC C20917
R601, R602, R603, R604, R605, R606, R607, R608: 10k; R_0603_1608Metric_Pad0.98x0.95mm_HandSolder; LCSC C25804

Connections:
/ChannelBankA/Channels/Channel 1: Q601.1 (G), R601.1; also elsewhere on the board
/ChannelBankA/Channels/Channel 2: Q602.1 (G), R602.1; also elsewhere on the board
/ChannelBankA/Channels/Channel 3: Q603.1 (G), R603.1; also elsewhere on the board
/ChannelBankA/Channels/Channel 4: Q604.1 (G), R604.1; also elsewhere on the board
/ChannelBankA/Channels/Channel 5: Q605.1 (G), R605.1; also elsewhere on the board
/ChannelBankA/Channels/Channel 6: Q606.1 (G), R606.1; also elsewhere on the board
/ChannelBankA/Channels/Channel 7: Q607.1 (G), R607.1; also elsewhere on the board
/ChannelBankA/Channels/Channel 8: Q608.1 (G), R608.1; also elsewhere on the board
/ChannelBankA/Channels/Continuity Sense 1: J601.1, Q601.3 (D); also elsewhere on the board
/ChannelBankA/Channels/Continuity Sense 2: J602.1, Q602.3 (D); also elsewhere on the board
/ChannelBankA/Channels/Continuity Sense 3: J603.1, Q603.3 (D); also elsewhere on the board
/ChannelBankA/Channels/Continuity Sense 4: J604.1, Q604.3 (D); also elsewhere on the board
/ChannelBankA/Channels/Continuity Sense 5: J605.1, Q605.3 (D); also elsewhere on the board
/ChannelBankA/Channels/Continuity Sense 6: J606.1, Q606.3 (D); also elsewhere on the board
/ChannelBankA/Channels/Continuity Sense 7: J607.1, Q607.3 (D); also elsewhere on the board
/ChannelBankA/Channels/Continuity Sense 8: J608.1, Q608.3 (D); also elsewhere on the board
/ChannelBankA/Rail: J601.2, J602.2, J603.2, J604.2, J605.2, J606.2, J607.2, J608.2; also elsewhere on the board
GND: Q601.2 (S), Q602.2 (S), Q603.2 (S), Q604.2 (S), Q605.2 (S), Q606.2 (S), Q607.2 (S), Q608.2 (S), R601.2, R602.2, R603.2, R604.2, R605.2, R606.2, R607.2, R608.2; also elsewhere on the board

Parts of its further copies:
J901: Igniter CH1; CamdenBoss_CTB932VE-2_1x02_P3.81mm_Vertical
J902: Igniter CH2; CamdenBoss_CTB932VE-2_1x02_P3.81mm_Vertical
J903: Igniter CH3; CamdenBoss_CTB932VE-2_1x02_P3.81mm_Vertical
J904: Igniter CH4; CamdenBoss_CTB932VE-2_1x02_P3.81mm_Vertical
J905: Igniter CH5; CamdenBoss_CTB932VE-2_1x02_P3.81mm_Vertical
J906: Igniter CH6; CamdenBoss_CTB932VE-2_1x02_P3.81mm_Vertical
J907: Igniter CH7; CamdenBoss_CTB932VE-2_1x02_P3.81mm_Vertical
J908: Igniter CH8; CamdenBoss_CTB932VE-2_1x02_P3.81mm_Vertical
Q901, Q902, Q903, Q904, Q905, Q906, Q907, Q908: AO3400A; SOT-23; LCSC C20917
R901, R902, R903, R904, R905, R906, R907, R908: 10k; R_0603_1608Metric_Pad0.98x0.95mm_HandSolder; LCSC C25804

Connections of its further copies:
/ChannelBankA/Rail: J901.2, J902.2, J903.2, J904.2, J905.2, J906.2, J907.2, J908.2; also elsewhere on the board
/ChannelBankB/Channels/Channel 1: Q901.1 (G), R901.1; also elsewhere on the board
/ChannelBankB/Channels/Channel 2: Q902.1 (G), R902.1; also elsewhere on the board
/ChannelBankB/Channels/Channel 3: Q903.1 (G), R903.1; also elsewhere on the board
/ChannelBankB/Channels/Channel 4: Q904.1 (G), R904.1; also elsewhere on the board
/ChannelBankB/Channels/Channel 5: Q905.1 (G), R905.1; also elsewhere on the board
/ChannelBankB/Channels/Channel 6: Q906.1 (G), R906.1; also elsewhere on the board
/ChannelBankB/Channels/Channel 7: Q907.1 (G), R907.1; also elsewhere on the board
/ChannelBankB/Channels/Channel 8: Q908.1 (G), R908.1; also elsewhere on the board
/ChannelBankB/Channels/Continuity Sense 1: J901.1, Q901.3 (D); also elsewhere on the board
/ChannelBankB/Channels/Continuity Sense 2: J902.1, Q902.3 (D); also elsewhere on the board
/ChannelBankB/Channels/Continuity Sense 3: J903.1, Q903.3 (D); also elsewhere on the board
/ChannelBankB/Channels/Continuity Sense 4: J904.1, Q904.3 (D); also elsewhere on the board
/ChannelBankB/Channels/Continuity Sense 5: J905.1, Q905.3 (D); also elsewhere on the board
/ChannelBankB/Channels/Continuity Sense 6: J906.1, Q906.3 (D); also elsewhere on the board
/ChannelBankB/Channels/Continuity Sense 7: J907.1, Q907.3 (D); also elsewhere on the board
/ChannelBankB/Channels/Continuity Sense 8: J908.1, Q908.3 (D); also elsewhere on the board
GND: Q901.2 (S), Q902.2 (S), Q903.2 (S), Q904.2 (S), Q905.2 (S), Q906.2 (S), Q907.2 (S), Q908.2 (S), R901.2, R902.2, R903.2, R904.2, R905.2, R906.2, R907.2, R908.2; also elsewhere on the board

Notes on the sheet:
IGNITION CHANNELS 1-8 of this bank (low-side switches) Bank A = CH1-8: J601-J608, Q601-Q608, R601-R608 Bank B = CH9-16: J901-J908, Q901-Q908, R901-R908 Terminal: Pin 2 = Ignition Rail, Pin 1 = igniter return AO3400A N-FET pulls the igniter to GND when 'Channel n' is high 10k gate pull-down keeps th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
