Croip3/MK4-Prototype/MK4-Proto/MK4-Proto.kicad_pcb

## KiCad design MK4-Proto/MK4-Proto.kicad_pcb (continued)

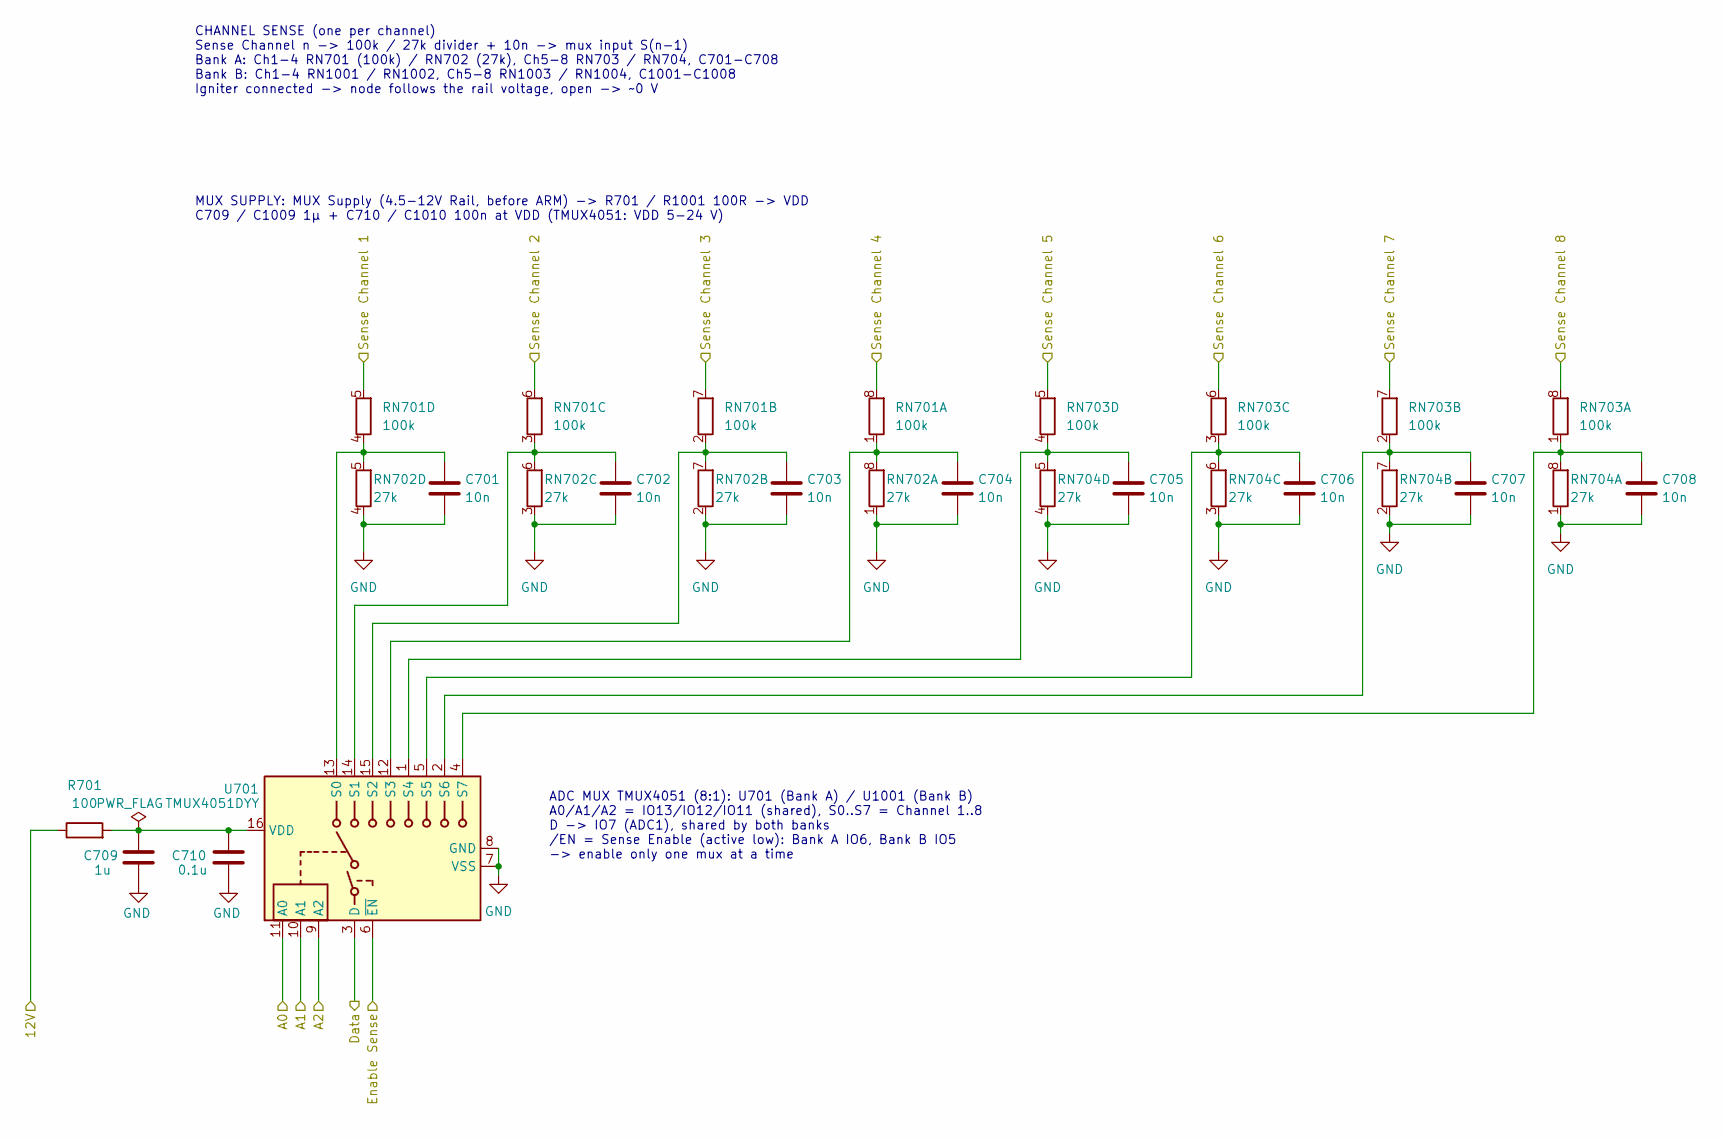
[picture p43: schematic ContinuityReading.kicad_sch, Continuity Sensing]

Parts:
C701, C702, C703, C704, C705, C706, C707, C708: 10n; C_0603_1608Metric; LCSC C57112
C709: 1u; C_0805_2012Metric_Pad1.18x1.45mm_HandSolder; LCSC C28323
C710: 0.1u; C_0805_2012Metric_Pad1.18x1.45mm_HandSolder; LCSC C49678
R701: 100; R_0603_1608Metric_Pad0.98x0.95mm_HandSolder; LCSC C22775
RN701, RN703: 100k; R_Array_Convex_4x0603; LCSC C1996
RN702, RN704: 27k; R_Array_Convex_4x0603; LCSC C25730
U701: TMUX4051DYY; Texas_DYY0016A_TSOT-23-16_2x4.2mm_P0.5mm; LCSC C22428440

Connections:
/ChannelBankA/A0: U701.11 (A0); also elsewhere on the board
/ChannelBankA/A1: U701.10 (A1); also elsewhere on the board
/ChannelBankA/A2: U701.9 (A2); also elsewhere on the board
/ChannelBankA/Channels/Continuity Sense 1: RN701.5 (R4.2); also elsewhere on the board
/ChannelBankA/Channels/Continuity Sense 2: RN701.6 (R3.2); also elsewhere on the board
/ChannelBankA/Channels/Continuity Sense 3: RN701.7 (R2.2); also elsewhere on the board
/ChannelBankA/Channels/Continuity Sense 4: RN701.8 (R1.2); also elsewhere on the board
/ChannelBankA/Channels/Continuity Sense 5: RN703.5 (R4.2); also elsewhere on the board
/ChannelBankA/Channels/Continuity Sense 6: RN703.6 (R3.2); also elsewhere on the board
/ChannelBankA/Channels/Continuity Sense 7: RN703.7 (R2.2); also elsewhere on the board
/ChannelBankA/Channels/Continuity Sense 8: RN703.8 (R1.2); also elsewhere on the board
/ChannelBankA/Data: U701.3 (D); also elsewhere on the board
/ChannelBankA/MUX Supply: R701.1; also elsewhere on the board
/ChannelBankA/Sense Enable: U701.6 (~EN); also elsewhere on the board
GND: C701.2, C702.2, C703.2, C704.2, C705.2, C706.2, C707.2, C708.2, C709.1, C710.1, RN702.1 (R1.1), RN702.2 (R2.1), RN702.3 (R3.1), RN702.4 (R4.1), RN704.1 (R1.1), RN704.2 (R2.1), RN704.3 (R3.1), RN704.4 (R4.1), U701.7 (VSS), U701.8 (GND); also elsewhere on the board
unnamed: C704.1, RN701.1 (R1.1), RN702.8 (R1.2), U701.12 (S3)
unnamed: C703.1, RN701.2 (R2.1), RN702.7 (R2.2), U701.15 (S2)
unnamed: C702.1, RN701.3 (R3.1), RN702.6 (R3.2), U701.14 (S1)
unnamed: C701.1, RN701.4 (R4.1), RN702.5 (R4.2), U701.13 (S0)
unnamed: C708.1, RN703.1 (R1.1), RN704.8 (R1.2), U701.4 (S7)
unnamed: C707.1, RN703.2 (R2.1), RN704.7 (R2.2), U701.2 (S6)
unnamed: C706.1, RN703.3 (R3.1), RN704.6 (R3.2), U701.5 (S5)
unnamed: C705.1, RN703.4 (R4.1), RN704.5 (R4.2), U701.1 (S4)
unnamed: C709.2, C710.2, R701.2, U701.16 (VDD)

Parts of its further copies:
C1001, C1002, C1003, C1004, C1005, C1006, C1007, C1008: 10n; C_0603_1608Metric; LCSC C57112
C1009: 1u; C_0805_2012Metric_Pad1.18x1.45mm_HandSolder; LCSC C28323
C1010: 0.1u; C_0805_2012Metric_Pad1.18x1.45mm_HandSolder; LCSC C49678
R1001: 100; R_0603_1608Metric_Pad0.98x0.95mm_HandSolder; LCSC C22775
RN1001, RN1003: 100k; R_Array_Convex_4x0603; LCSC C1996
RN1002, RN1004: 27k; R_Array_Convex_4x0603; LCSC C25730
U1001: TMUX4051DYY; Texas_DYY0016A_TSOT-23-16_2x4.2mm_P0.5mm; LCSC C22428440

Connections of its further copies:
/ChannelBankA/A0: U1001.11 (A0); also elsewhere on the board
/ChannelBankA/A1: U1001.10 (A1); also elsewhere on the board
/ChannelBankA/A2: U1001.9 (A2); also elsewhere on the board
/ChannelBankA/Data: U1001.3 (D); also elsewhere on the board
/ChannelBankA/MUX Supply: R1001.1; also elsewhere on the board
/ChannelBankB/Channels/Continuity Sense 1: RN1001.5 (R4.2); also elsewhere on the board
/ChannelBankB/Channels/Continuity Sense 2: RN1001.6 (R3.2); also elsewhere on the board
/ChannelBankB/Channels/Continuity Sense 3: RN1001.7 (R2.2); also elsewhere on the board
/ChannelBankB/Channels/Continuity Sense 4: RN1001.8 (R1.2); also elsewhere on the board
/ChannelBankB/Channels/Continuity Sense 5: RN1003.5 (R4.2); also elsewhere on the board
/ChannelBankB/Channels/Continuity Sense 6: RN1003.6 (R3.2); also elsewhere on the board
/ChannelBankB/Channels/Continuity Sense 7: RN1003.7 (R2.2); also elsewhere on the board
/ChannelBankB/Channels/Continuity Sense 8: RN1003.8 (R1.2); also elsewhere on the board
/ChannelBankB/Sense Enable: U1001.6 (~EN); also elsewhere on the board
GND: C1001.2, C1002.2, C1003.2, C1004.2, C1005.2, C1006.2, C1007.2, C1008.2, C1009.1, C1010.1, RN1002.1 (R1.1), RN1002.2 (R2.1), RN1002.3 (R3.1), RN1002.4 (R4.1), RN1004.1 (R1.1), RN1004.2 (R2.1), RN1004.3 (R3.1), RN1004.4 (R4.1), U1001.7 (VSS), U1001.8 (GND); also elsewhere on the board
unnamed: C1004.1, RN1001.1 (R1.1), RN1002.8 (R1.2), U1001.12 (S3)
unnamed: C1003.1, RN1001.2 (R2.1), RN1002.7 (R2.2), U1001.15 (S2)
unnamed: C1002.1, RN1001.3 (R3.1), RN1002.6 (R3.2), U1001.14 (S1)
unnamed: C1001.1, RN1001.4 (R4.1), RN1002.5 (R4.2), U1001.13 (S0)
unnamed: C1008.1, RN1003.1 (R1.1), RN1004.8 (R1.2), U1001.4 (S7)
unnamed: C1007.1, RN1003.2 (R2.1), RN1004.7 (R2.2), U1001.2 (S6)
unnamed: C1006.1, RN1003.3 (R3.1), RN1004.6 (R3.2), U1001.5 (S5)
unnamed: C1005.1, RN1003.4 (R4.1), RN1004.5 (R4.2), U1001.1 (S4)
unnamed: C1009.2, C1010.2, R1001.2, U1001.16 (VDD)

Notes on the sheet:
MUX SUPPLY: MUX Supply (4.5-12V Rail, before ARM) -> R701 / R1001 100R -> VDD C709 / C1009 1µ + C710 / C1010 100n at VDD (TMUX4051: VDD 5-24 V)
ADC MUX TMUX4051 (8:1): U701 (Bank A) / U1001 (Bank B) A0/A1/A2 = IO13/IO12/IO11 (shared), S0..S7 = Channel 1..8 D -> IO7 (ADC1), shared by both banks /EN = Sense Enable (active low): Bank A IO6, Bank B IO5 -> enable only one mux at a time
CHANNEL SENSE (one per channel) Sense Channel n -> 100k / 27k divider + 10n -> mux input S(n-1) Bank A: Ch1-4 RN701 (100k) / RN702 (27k), Ch5-8 RN703 / RN704, C701-C708 Bank B: Ch1-4 RN1001 / RN1002, Ch5-8 RN1003 / RN1004, C1001-C1008 Igniter connected -> node follows the rail voltage, open -> ~0 V

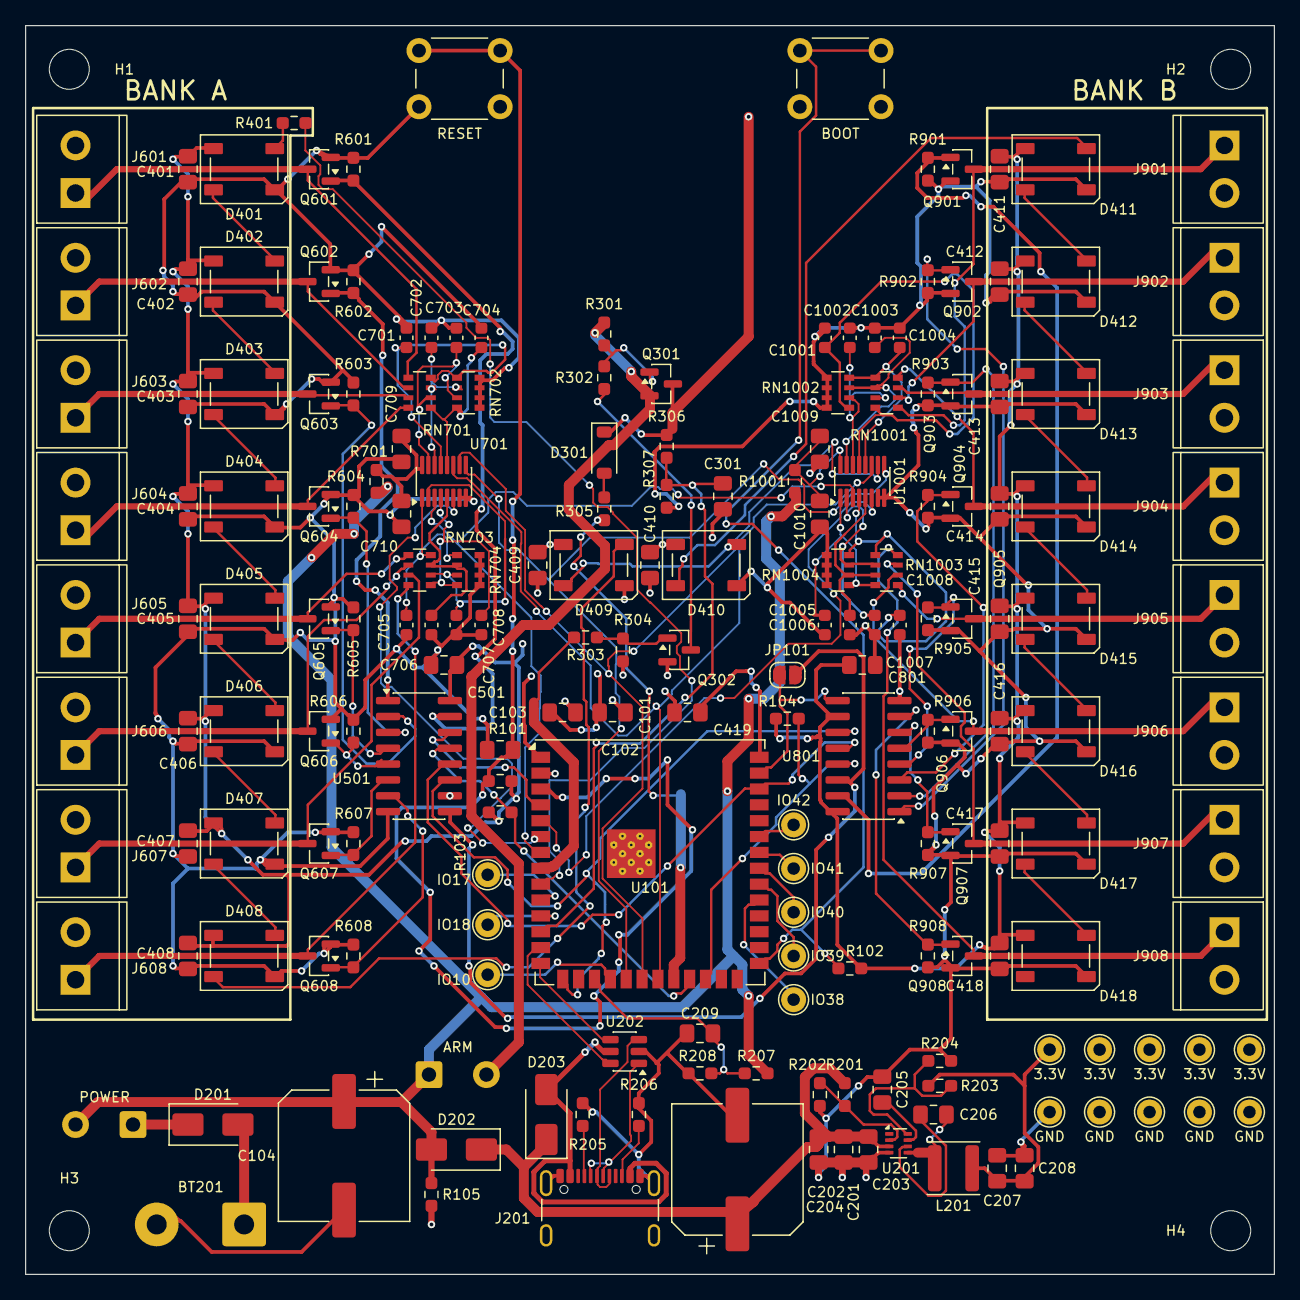
[picture p44: board MK4-Proto.kicad_pcb from above]

Board: 4 copper layers, 100.0 x 100.0 mm, 196 parts (1 on the bottom side), 120 nets.

Other parts of the board:
H1, H2, H3, H4: MountingHole_3.2mm_M3
LOGO1: Logo_Longarm
