Croip3/MK4-Prototype/(commit log)

2026-10-29 first pcb version
    [ContinuityReading.kicad_sch, MK4-Proto.kicad_pcb, MK4-Proto.kicad_sch, PowerManagement.kicad_sch, channels.kicad_sch, leds.kicad_sch, testing.kicad_sch, untitled.kicad_sch]
2026-10-30 changed buck converter to TPS62933 because of better USB-Voltage compatability
    [MK4-Proto.kicad_sch, PowerManagement.kicad_sch]
2026-10-31 symbol renaming
    [ContinuityReading.kicad_sch, MK4-Proto.kicad_pcb, MK4-Proto.kicad_sch, PowerManagement.kicad_sch, Referenz-Umbenennung.csv, channels.kicad_sch, leds.kicad_sch, testing.kicad_sch]
2026-11-01 adopted to 2-Bank design -> 16 instead of 8 channels
    [ContinuityReading.kicad_sch, MK4-Proto.kicad_sch, channelBank.kicad_sch, channels.kicad_sch, leds.kicad_sch]
2026-11-01 smaller fixes + added free digital IO/GND/3.3V solder points
    [ContinuityReading.kicad_sch, MK4-Proto.kicad_pcb, MK4-Proto.kicad_sch, PowerManagement.kicad_sch, channelBank.kicad_sch, channelHandler.kicad_sch, channels.kicad_sch, leds.kicad_sch]
2026-11-05 pcb - layout for power and rail control
    [ContinuityReading.kicad_sch, MK4-Proto.kicad_pcb, MK4-Proto.kicad_sch, PowerManagement.kicad_sch, Referenz-Umbenennung.csv, channelBank.kicad_sch, channelHandler.kicad_sch, channels.kicad_sch]
2026-11-05 first pcb placement + routing
    [ContinuityReading.kicad_sch, MK4-Proto.kicad_pcb, MK4-Proto.kicad_sch, MK4-Proto_routed.kicad_pcb, PowerManagement.kicad_sch, channels.kicad_sch]
2026-11-11 pcb finished - added capacitor discharge resistor - corrected object rotations for jlcpcb
    [ContinuityReading.kicad_sch, MK4-Proto.kicad_pcb, MK4-Proto.kicad_sch, PowerManagement.kicad_sch, channelBank.kicad_sch, channels.kicad_sch, leds.kicad_sch, testing.kicad_sch]
2026-11-11 first ai generated prototype for a housing
    [MK4_01_Unterteil.3mf, MK4_01_Unterteil.step, MK4_01_Unterteil__Unterteil.stl, MK4_02_Haube.3mf, MK4_02_Haube.step, MK4_02_Haube__Haube_Beschriftung_Kontrastfarbe.stl, MK4_02_Haube__Haube_Koerper.stl, MK4_02_Haube__Haube_Lichtleiter_transparent.stl]
